OpenSourceSDRLab/B210-Kintex-7/hardware/mechanical/B210-Kintex-7_3D.step

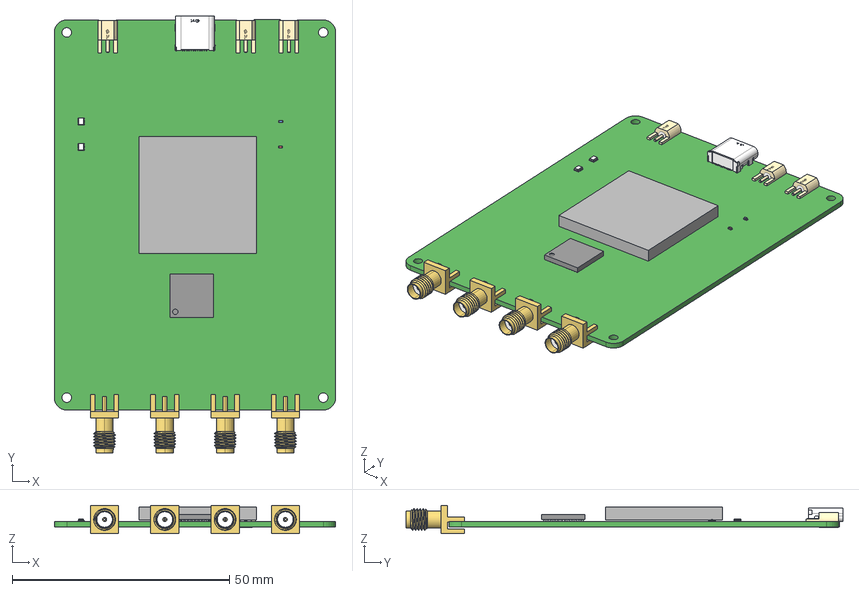
[picture p3: CAD file, 2026-09-02]
hardware/mechanical/B210-Kintex-7_3D.step
64.7 x 100.5 x 6.51 mm
LED-SMD_4P-L1.6-W1.5_F.1615.00003-P4-1615R1G1TA2-06T-001~LED-SMD_ 4P-L1.6-W1.5_F.1615.00003-P4-1615R1G1TA2-06T-001~NGzz x 2
LED-SMD_4P-L1.6-W1.5_F.1615.00003-P4-1615R1G1TA2-06T-001~LED-SMD_ 4P-L1.6-W1.5_F.1615.00003-P4-1615R1G1TA2-06T-001~NGzz001 x 2
LED-SMD_4P-L1.6-W1.5_F.1615.00003-P4-1615R1G1TA2-06T-001~LED-SMD_ 4P-L1.6-W1.5_F.1615.00003-P4-1615R1G1TA2-06T-001~NGzz002 x 2
LED-SMD_4P-L1.6-W1.5_F.1615.00003-P4-1615R1G1TA2-06T-001~LED-SMD_ 4P-L1.6-W1.5_F.1615.00003-P4-1615R1G1TA2-06T-001~NGzz003 x 2
LED-SMD_4P-L1.6-W1.5_F.1615.00003-P4-1615R1G1TA2-06T-001~LED-SMD_ 4P-L1.6-W1.5_F.1615.00003-P4-1615R1G1TA2-06T-001~NGzz004 x 2
LED-SMD_4P-L1.6-W1.5_F.1615.00003-P4-1615R1G1TA2-06T-001~LED-SMD_ 4P-L1.6-W1.5_F.1615.00003-P4-1615R1G1TA2-06T-001~NGzz005 x 2
LED-SMD_4P-L1.6-W1.5_F.1615.00003-P4-1615R1G1TA2-06T-001~LED-SMD_ 4P-L1.6-W1.5_F.1615.00003-P4-1615R1G1TA2-06T-001~NGzz006 x 2
LED-SMD_4P-L1.6-W1.5_F.1615.00003-P4-1615R1G1TA2-06T-001~LED-SMD_ 4P-L1.6-W1.5_F.1615.00003-P4-1615R1G1TA2-06T-001~NGzz007 x 2
LED-SMD_4P-L1.6-W1.5_F.1615.00003-P4-1615R1G1TA2-06T-001~LED-SMD_ 4P-L1.6-W1.5_F.1615.00003-P4-1615R1G1TA2-06T-001~NGzz008 x 2
LED-SMD_4P-L1.6-W1.5_F.1615.00003-P4-1615R1G1TA2-06T-001~LED-SMD_ 4P-L1.6-W1.5_F.1615.00003-P4-1615R1G1TA2-06T-001~NGzz009 x 2
Extruded
SMA-SMD_73415-0963~SMA-SMD_73415-0963~VM4T x 3
USB-C-SMD_TYPE-C-24P-QT~USB-C-SMD_TYPE-C-24P-QT~8yyD
USB-C-SMD_TYPE-C-24P-QT~USB-C-SMD_TYPE-C-24P-QT~8yyD001
USB-C-SMD_TYPE-C-24P-QT~USB-C-SMD_TYPE-C-24P-QT~8yyD002
USB-C-SMD_TYPE-C-24P-QT~USB-C-SMD_TYPE-C-24P-QT~8yyD003
USB-C-SMD_TYPE-C-24P-QT~USB-C-SMD_TYPE-C-24P-QT~8yyD004
USB-C-SMD_TYPE-C-24P-QT~USB-C-SMD_TYPE-C-24P-QT~8yyD005
USB-C-SMD_TYPE-C-24P-QT~USB-C-SMD_TYPE-C-24P-QT~8yyD006
USB-C-SMD_TYPE-C-24P-QT~USB-C-SMD_TYPE-C-24P-QT~8yyD007
USB-C-SMD_TYPE-C-24P-QT~USB-C-SMD_TYPE-C-24P-QT~8yyD008
USB-C-SMD_TYPE-C-24P-QT~USB-C-SMD_TYPE-C-24P-QT~8yyD009
USB-C-SMD_TYPE-C-24P-QT~USB-C-SMD_TYPE-C-24P-QT~8yyD010
USB-C-SMD_TYPE-C-24P-QT~USB-C-SMD_TYPE-C-24P-QT~8yyD011
USB-C-SMD_TYPE-C-24P-QT~USB-C-SMD_TYPE-C-24P-QT~8yyD012
USB-C-SMD_TYPE-C-24P-QT~USB-C-SMD_TYPE-C-24P-QT~8yyD013
USB-C-SMD_TYPE-C-24P-QT~USB-C-SMD_TYPE-C-24P-QT~8yyD014
User Library-led_0402
SMA-KE x 4
LOGOԲ0.25 x 4
User Library-led_0402LED0402 blue
