OpenSourceSDRLab/B210-Kintex-7/(list of files, cad)

Other CAD files:
hardware/mechanical/B210-Kintex-7_outline.dwg
