OpenSourceSDRLab/B210-Kintex-7/hardware/B210-Kintex-7_Schematic.pdf

# © 2026 OpenSourceSDRLab. All rights reserved. · www.opensourcesdrlab.com

# OPENSOURCESDRLAB DOCUMENTATION

# B210-Kintex-7 Schematic

Product | B210-Kintex-7
Document | OSSDRLAB-B210-Kintex-7-SCH
Version | 2.1
Date | 2026-11-12

Circuit schematic (board revision V2.1) of the OpenSourceSDRLab B210-Kintex-7, a USRP B210-compatible SDR with an Analog Devices AD9361 and a Xilinx Kintex-7 XC7K325T FPGA. Exported from Altium Designer (A4); sheet 13 is blank.

Sheet | Content
1–2 | USB 3.0: CYUSB3014 (FX3) controller, GPIF II bus, Type-C connector and FX3 supply
3 | Power: MP2143 step-down converters, TPS7A9201 low-noise LDOs
4–5 | FPGA configuration, core supply (TPS53355), power pins and decoupling
6–7 | FPGA HR/HP I/O banks: AD9361 interface, FX3 GPIF II, PLL, GPS, GPIO
8 | AD9361 RF transceiver
9–10 | RF front ends, channel 1 (TRX1, RX1) and channel 2 (TRX2, RX2)
11 | Status LEDs, GPIO/JTAG FPC connector
12 | Clocking: ADF4001 PLL, 10 MHz and PPS inputs, onboard GPS module

# Product page: https://opensourcesdrlab.com/products/b210-kintex-7

# Questions about the hardware: support@opensourcesdrlab.com

11

22

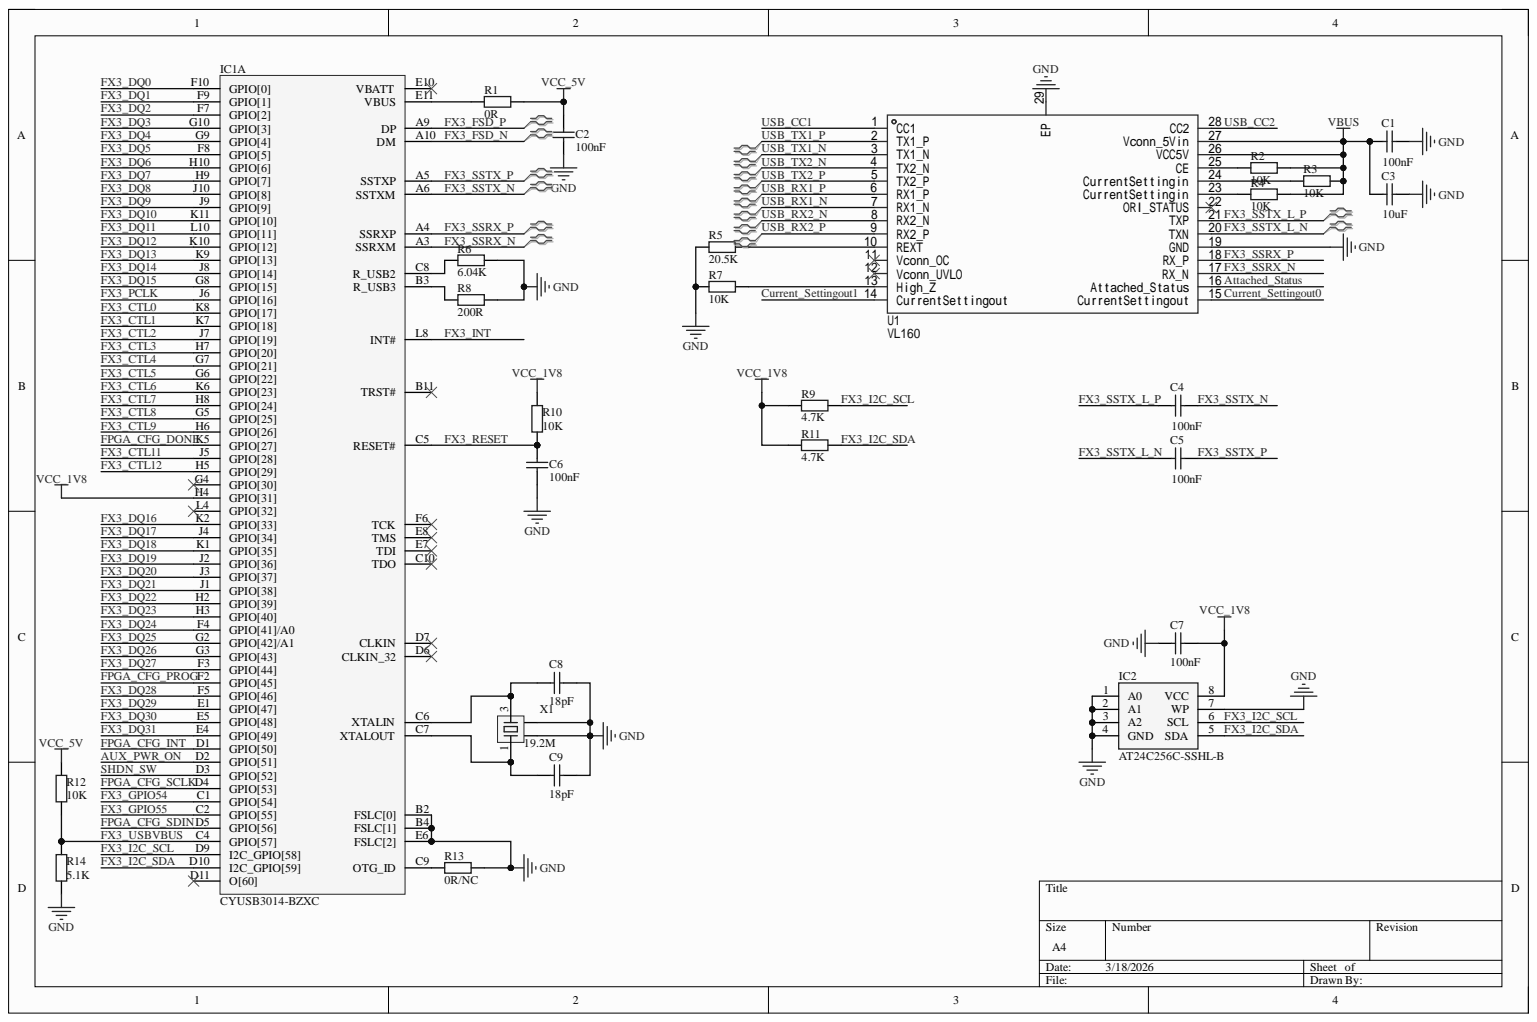
[picture p8: page 2]

A | A
NC | A11

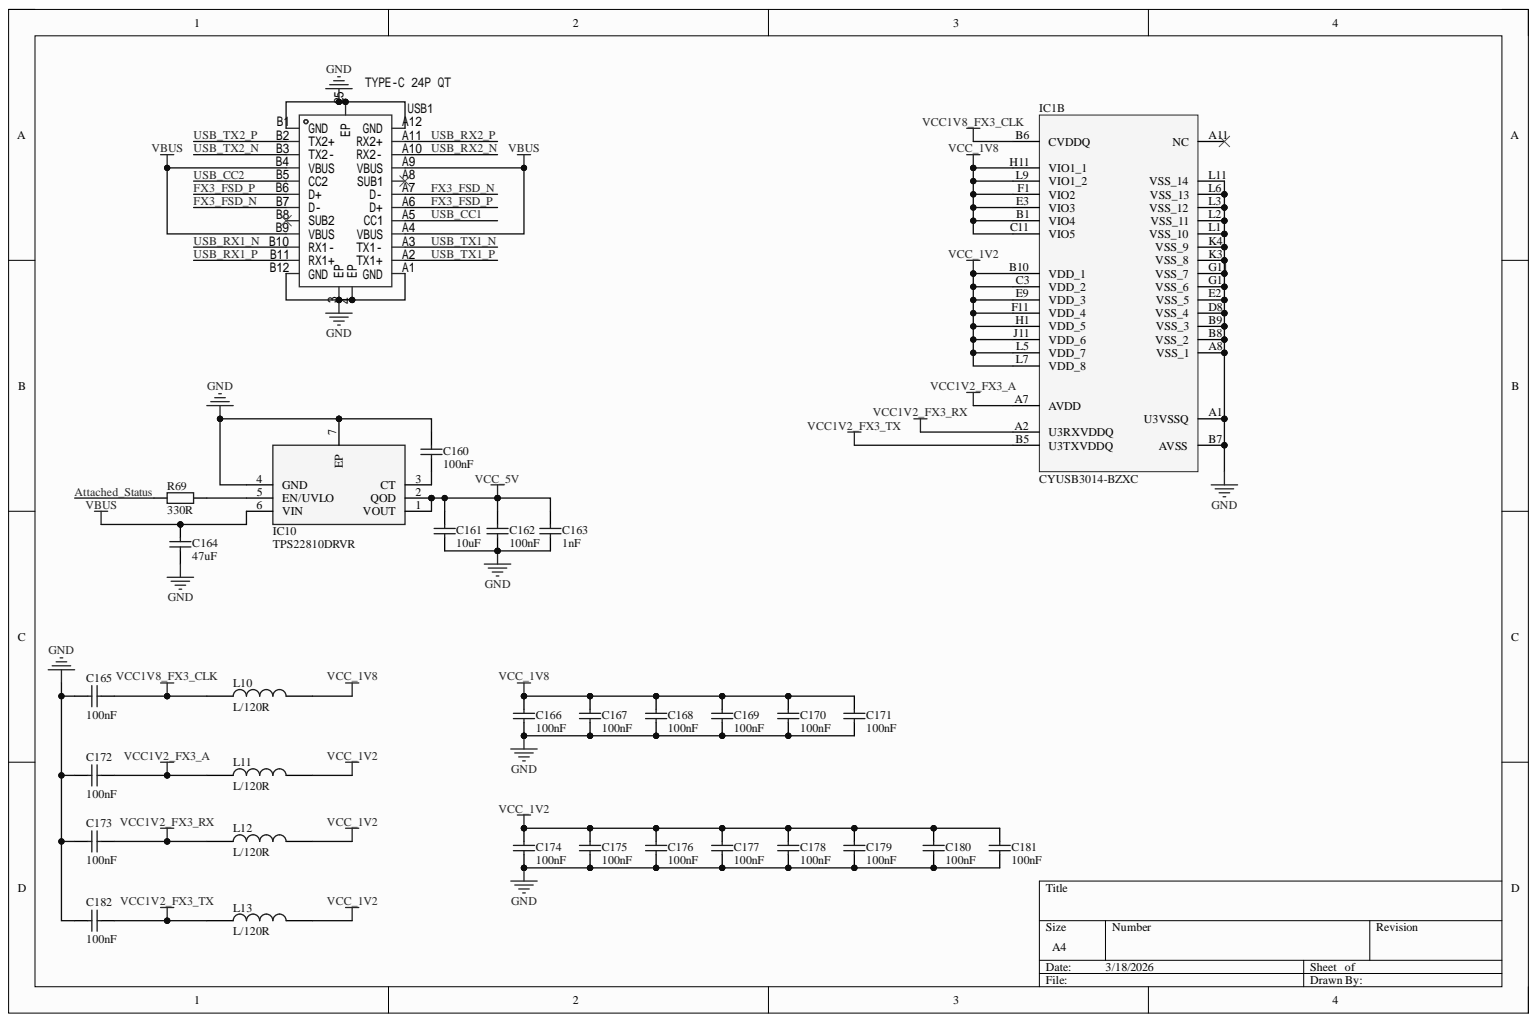
[picture p9: page 3]

A | A
PG | 1

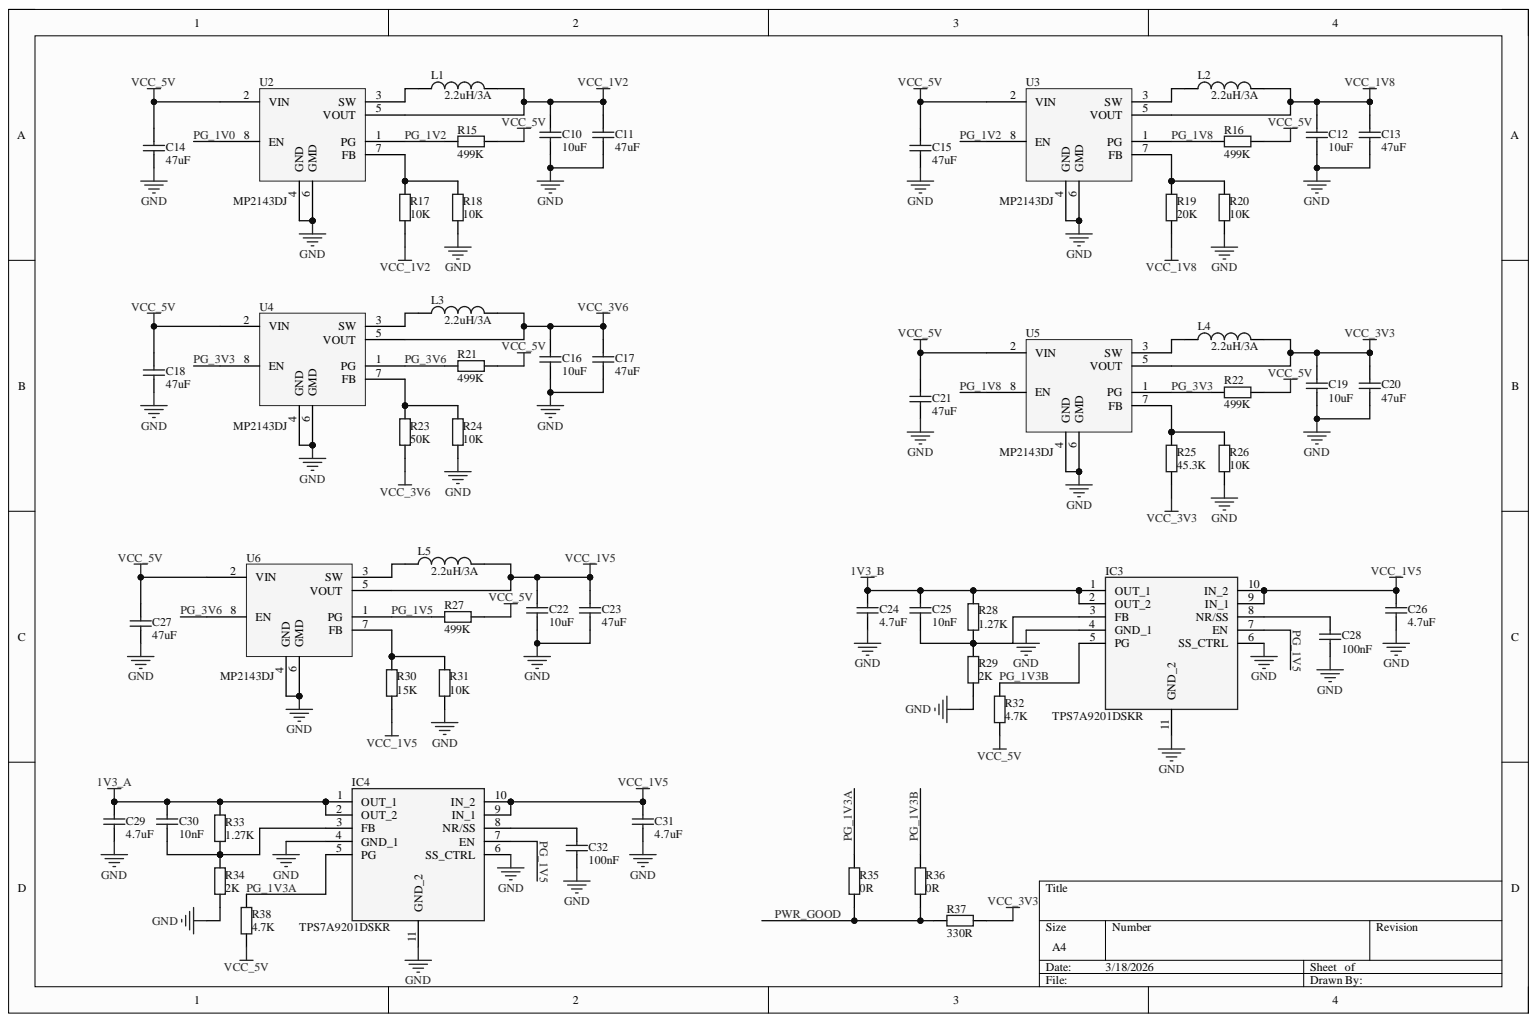
[picture p10: page 4]

A | A
INIT_B_0 G7 | DONE_0 J7

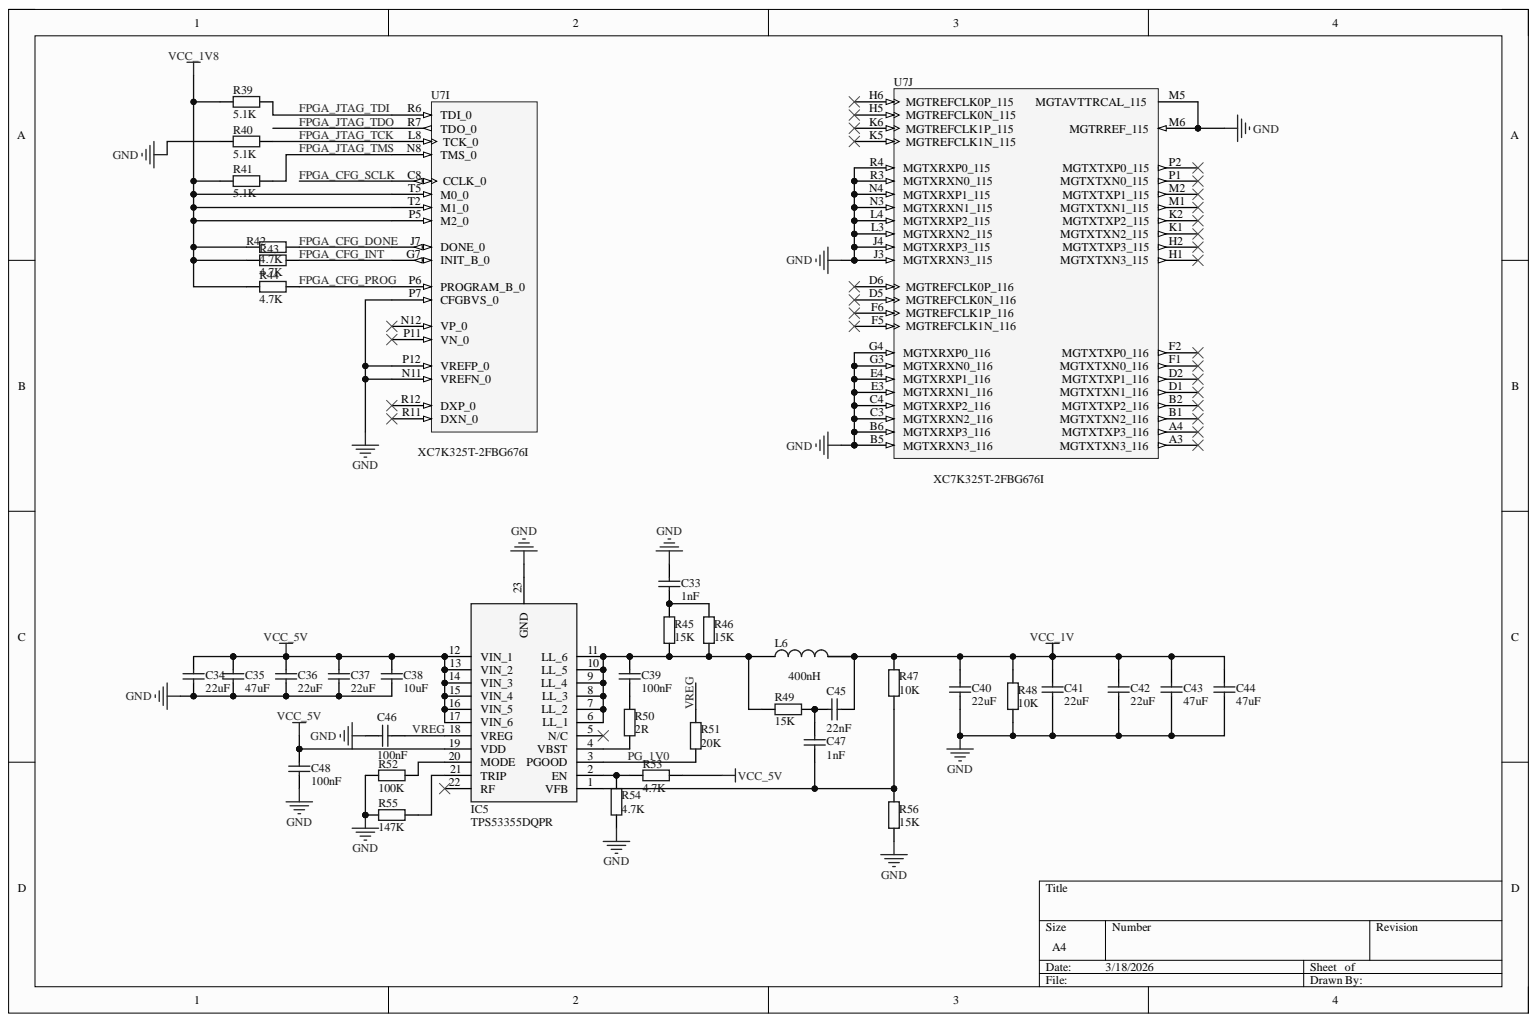
[picture p11: page 5]

VCCINT U15 | VCCINT T14 | VCCINT R15 | VCCINT P14 | VCCINT N15 | VCCINT N9 | VCCINT M14 | VCCINT M8 | VCCINT L15 | VCCINT L13 | VCCINT L9 | VCCINT K14 | VCCINT K12 | VCCINT K10 | VCCINT K8 | VCCINT J9
GND | Y19 GND | Y9 GND | W22 GND | W12 GND | W2 GND | V25 GND | V15 GND | V5 GND | U18 GND | U14 GND | U12 GND | U10 GND | U8 GND | T21 GND | T15 GND | T13 GND | T11 GND | T9 GND | T4 GND | T3 GND | T1 GND | R24 GND | R14 GND | R10 GND | R8 GND | R5 GND | R2 GND | R1 GND | P17 GND | P15 GND | P13 GND | P9 GND | P4 GND | P3 GND | N20 GND | N14 GND | N10 GND | N7 GND | N5 GND | N2 GND | N1 GND | M23 GND | M15 GND | M13

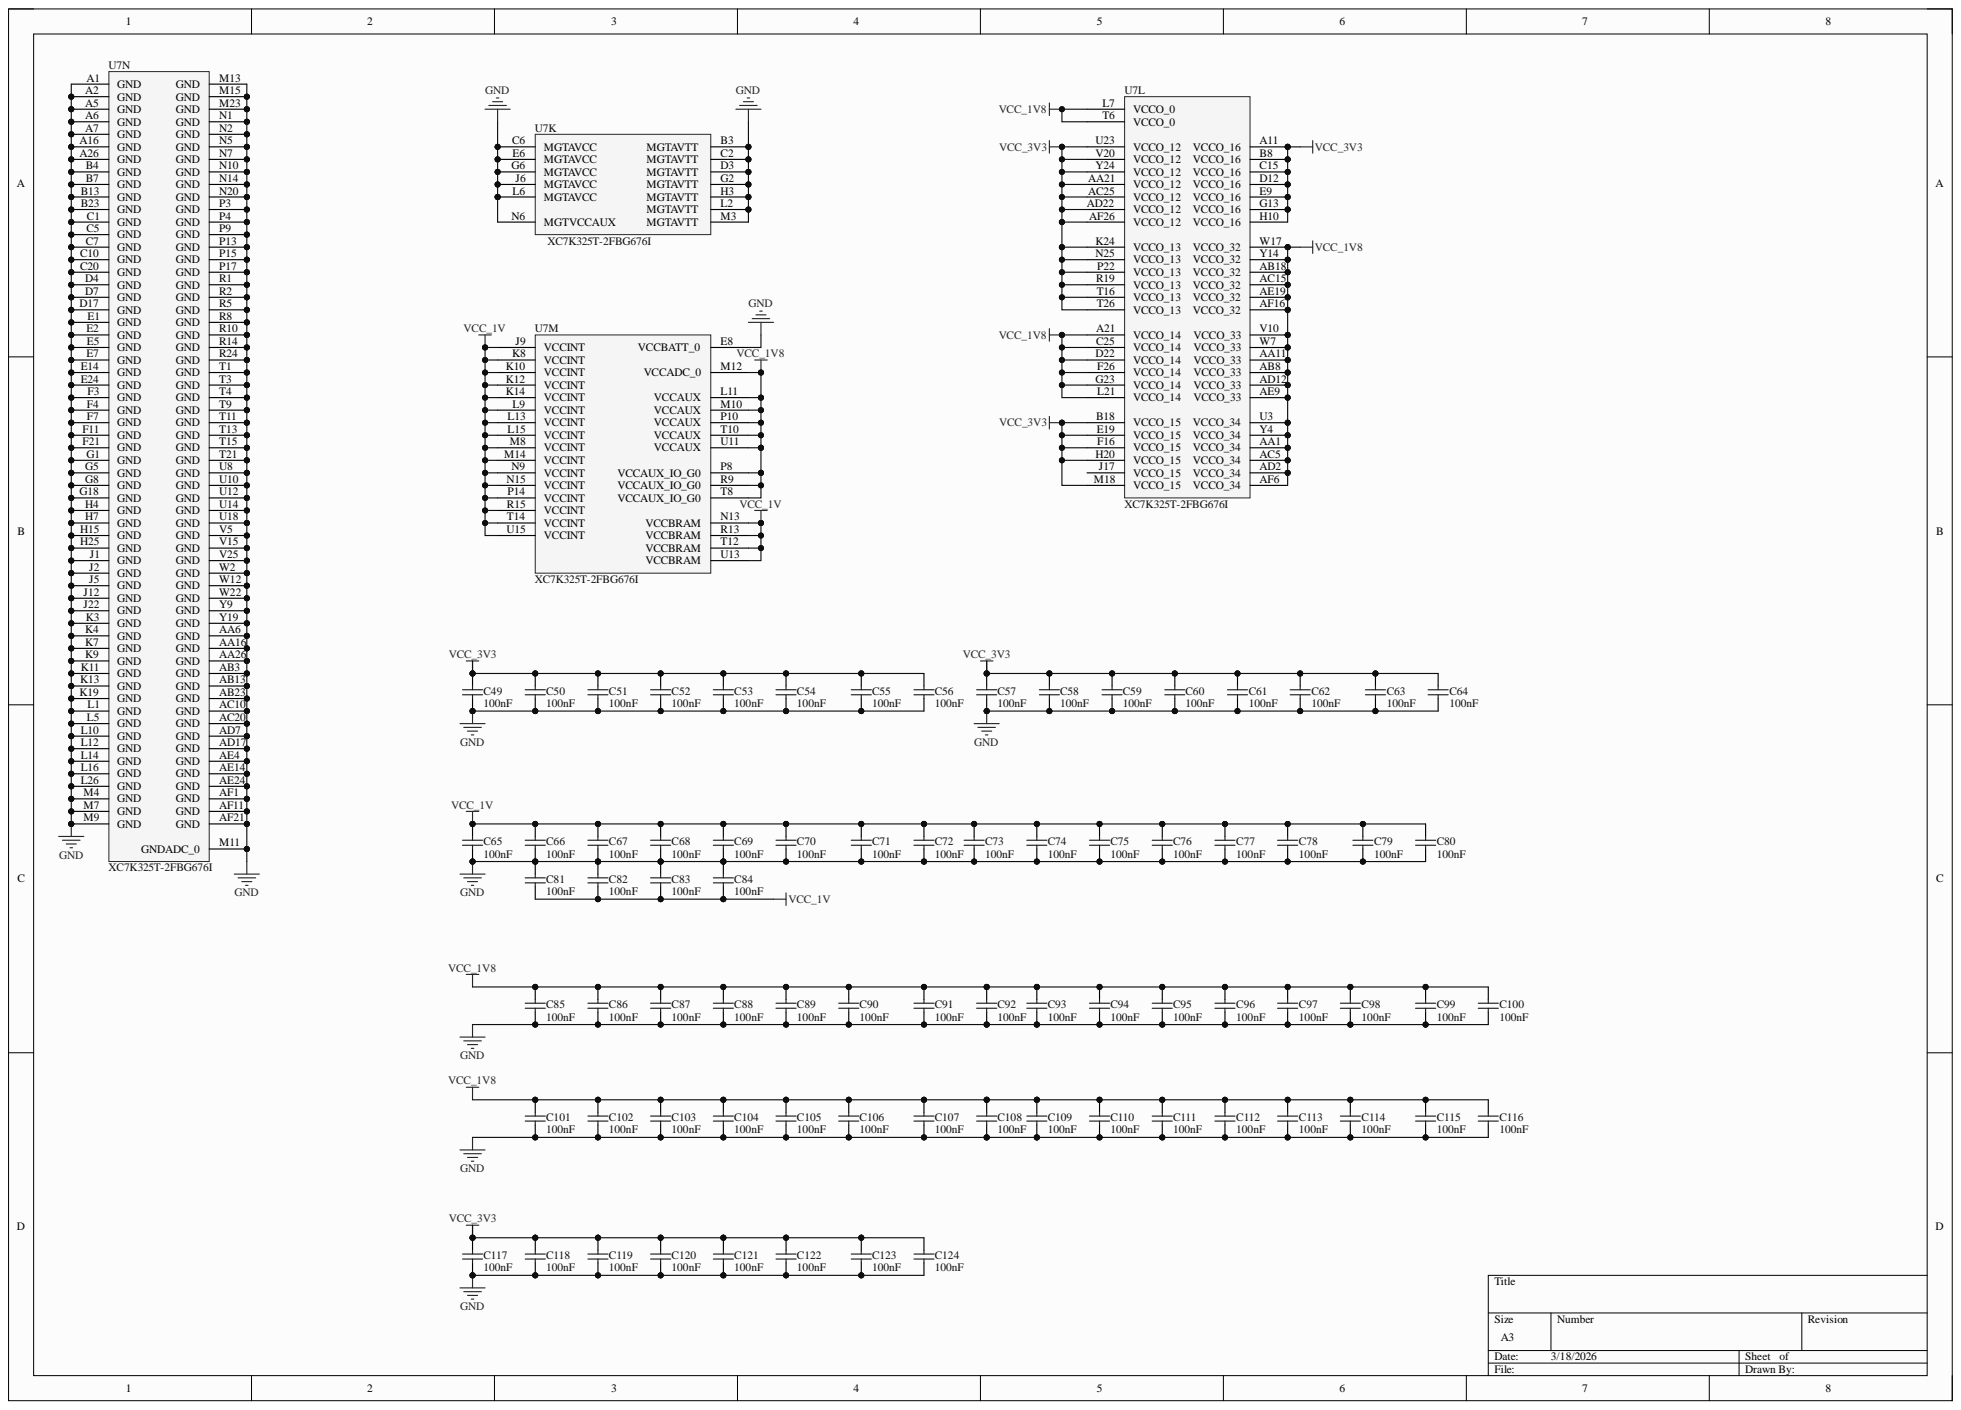
[picture p12: page 6]

# U7A XC7K325T

# U7B XC7K325T

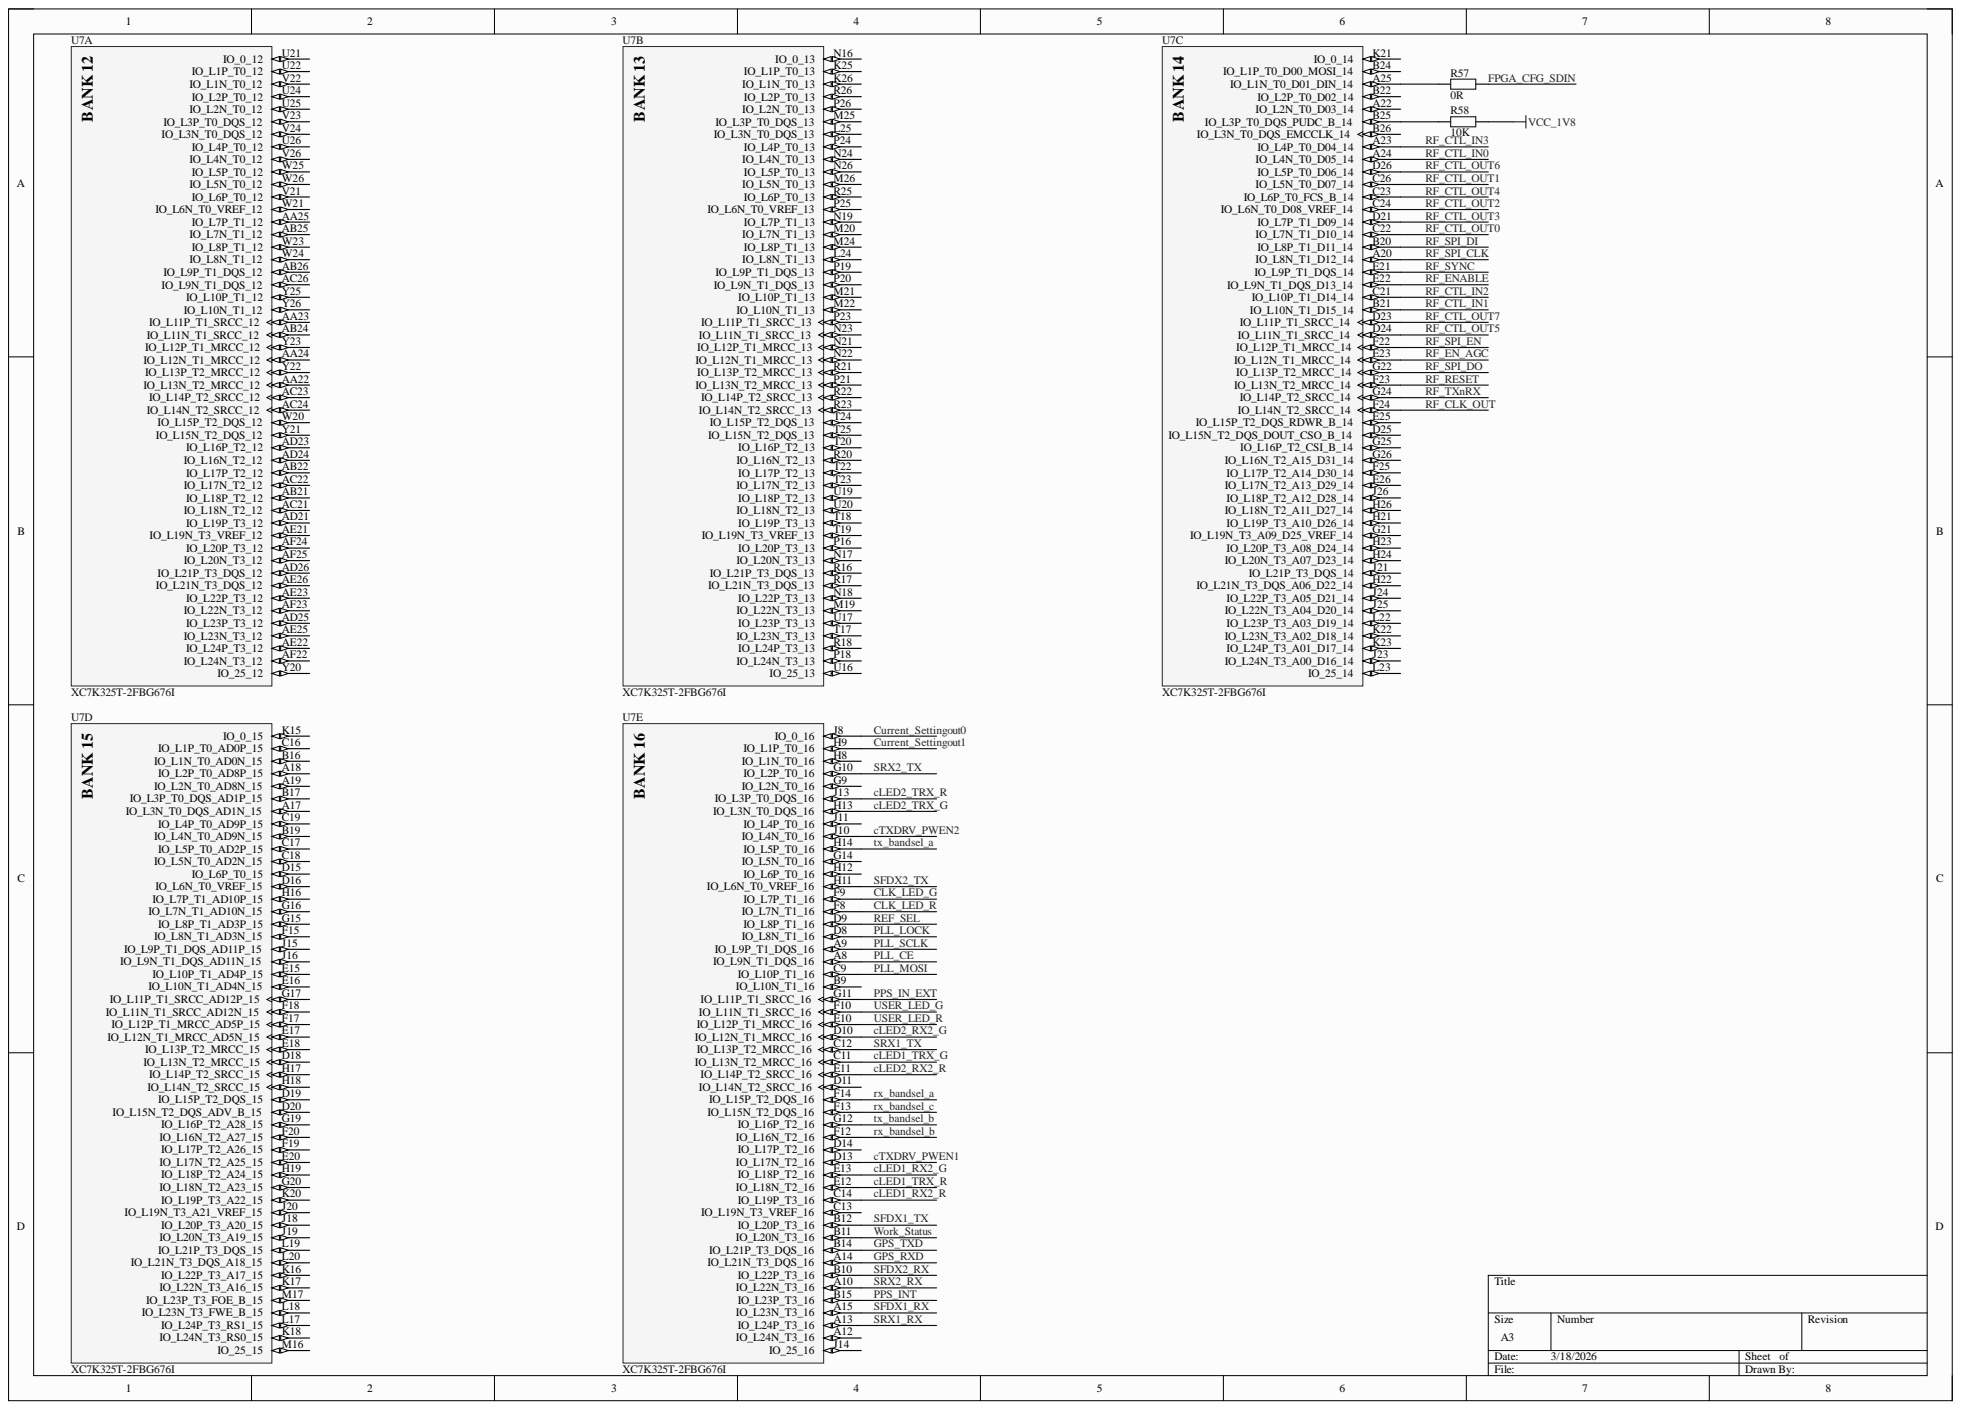
[picture p13: page 7]

11

22

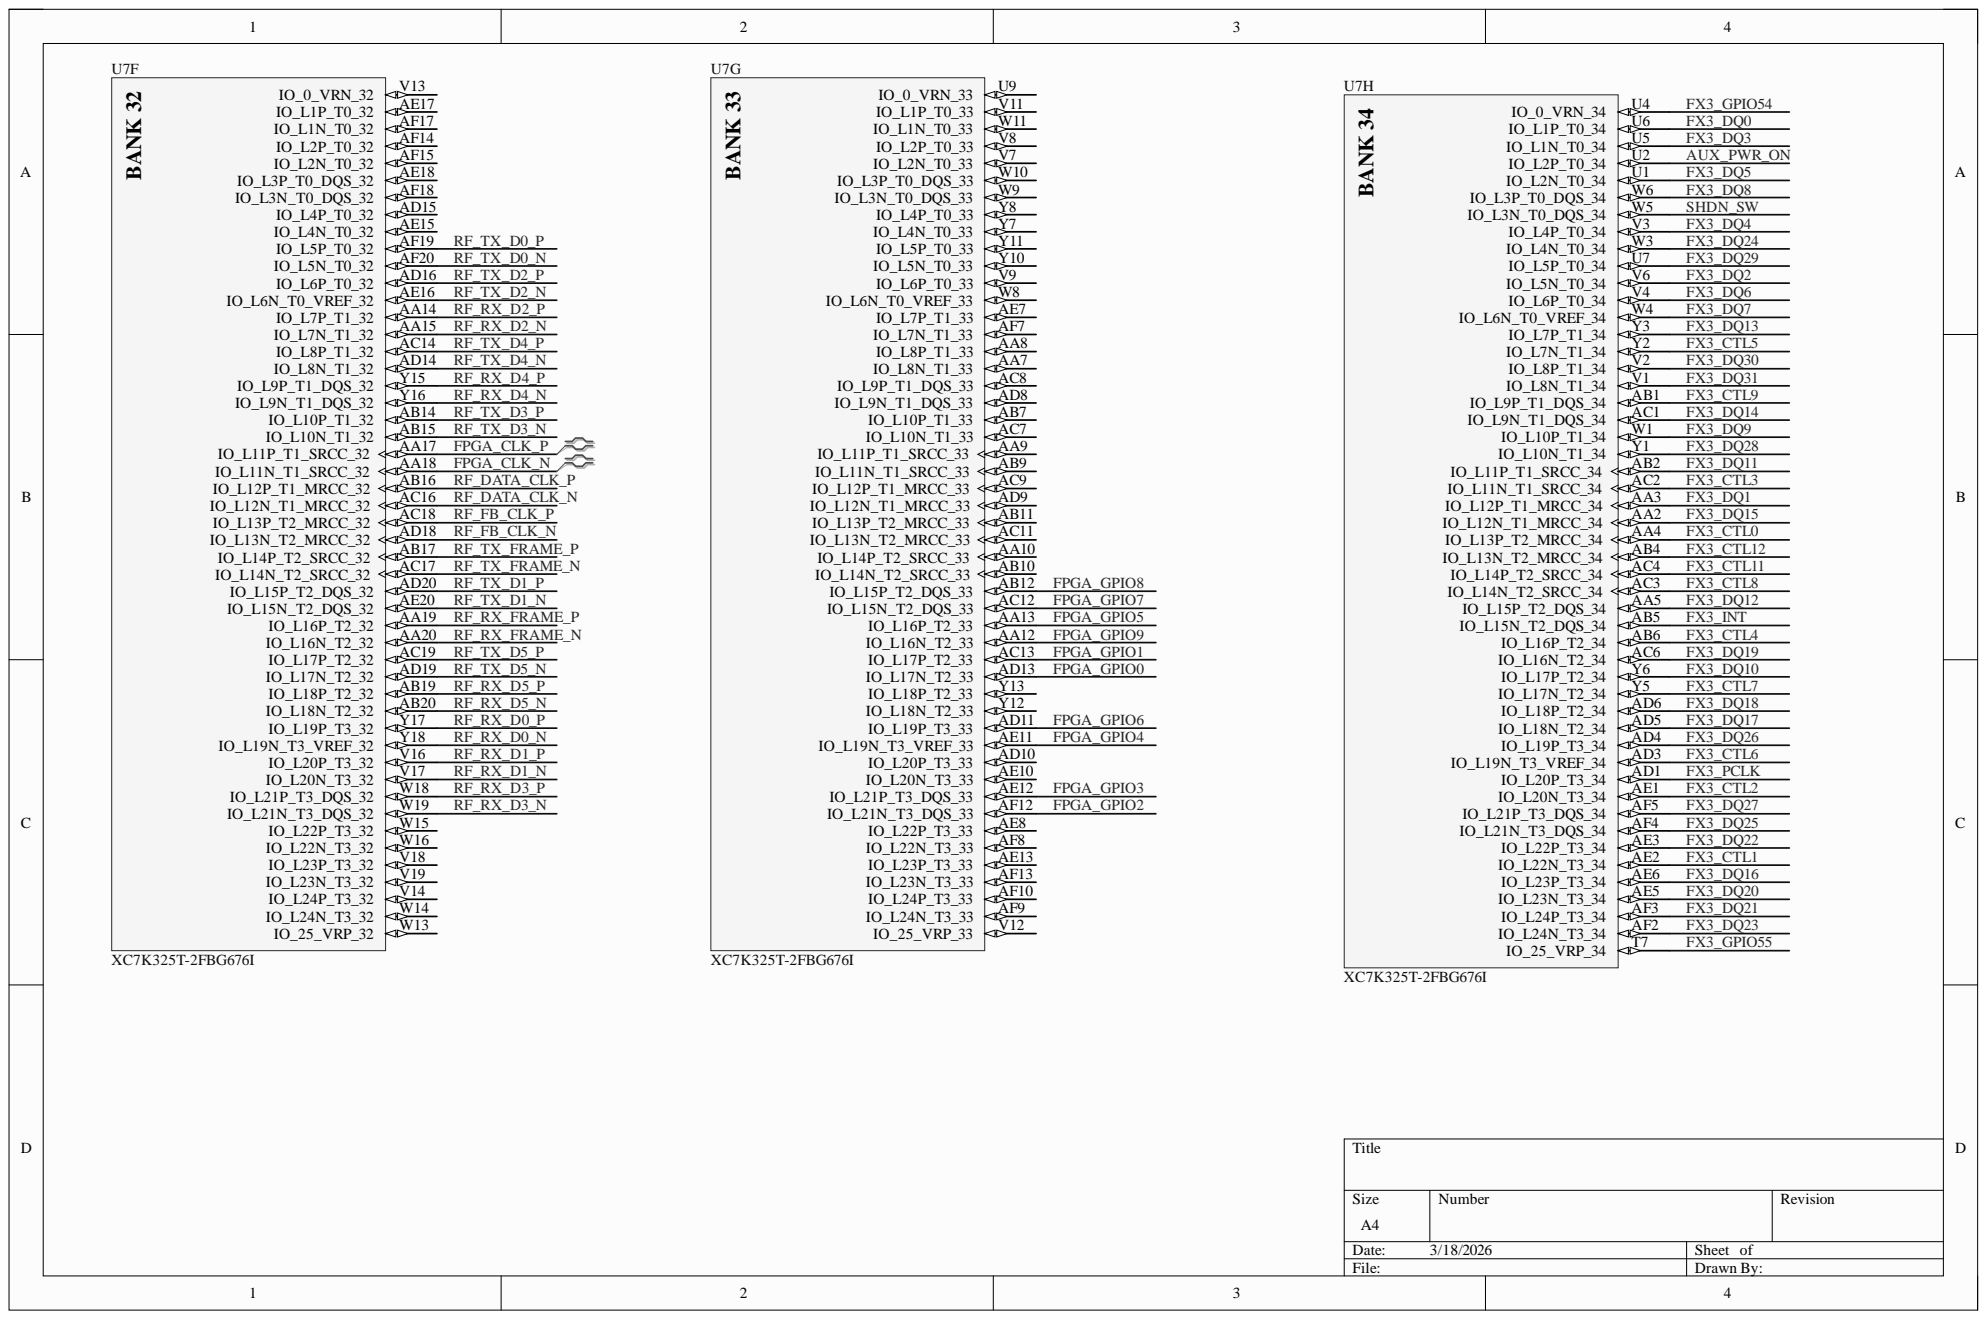
[picture p14: page 8]

11

22

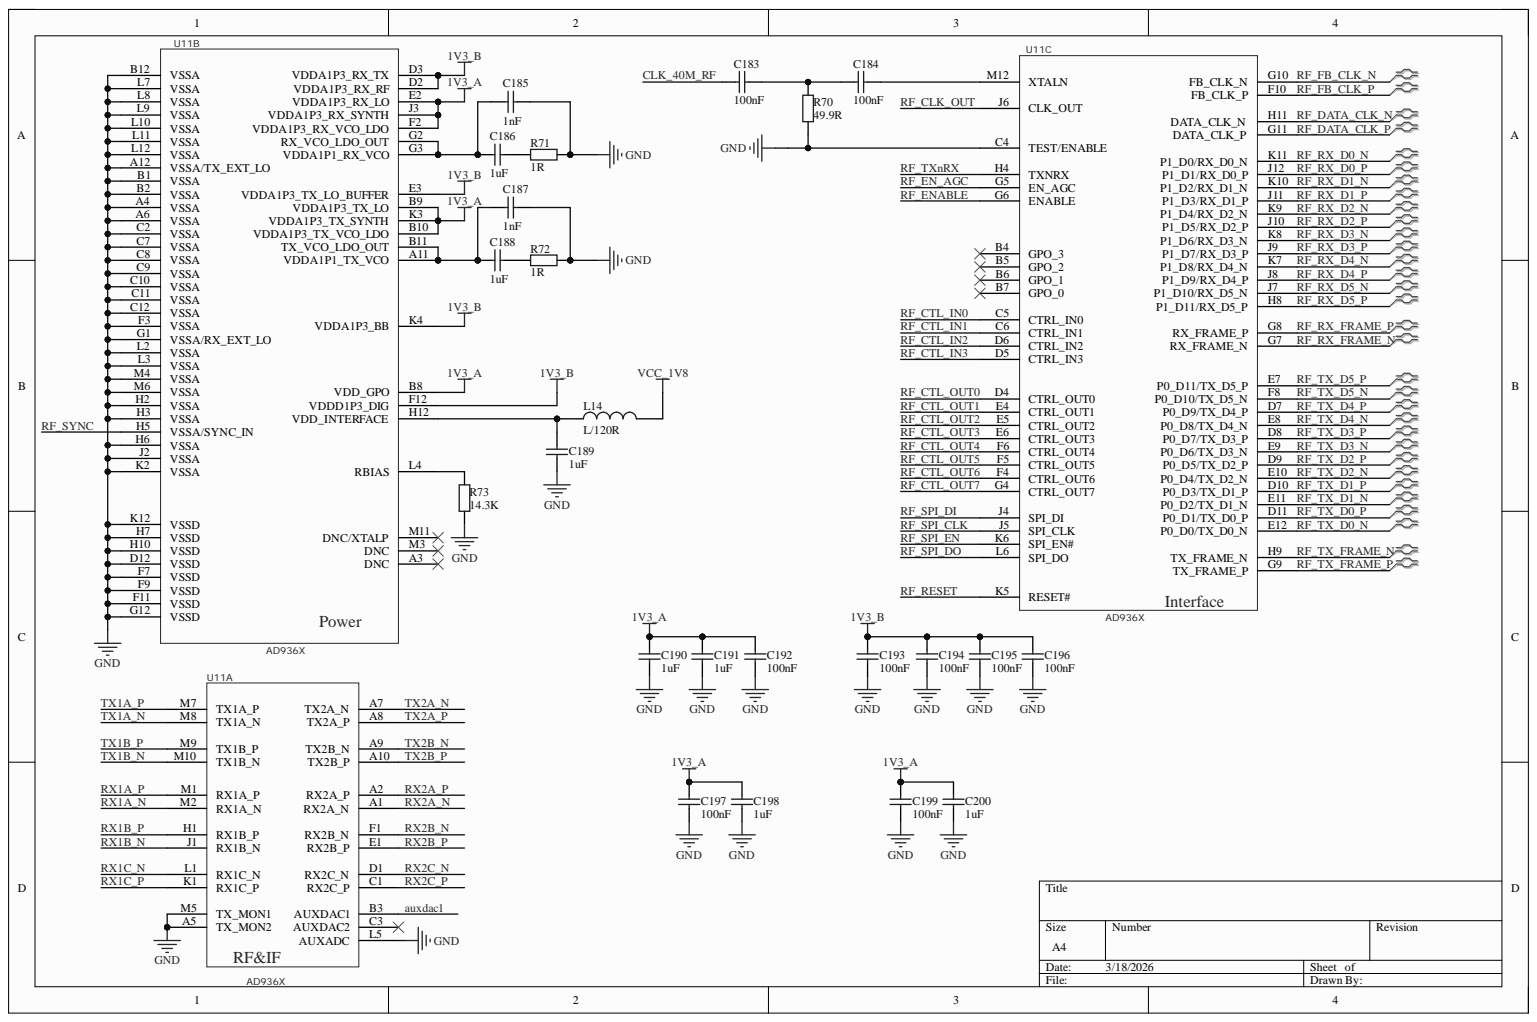
[picture p15: page 9]

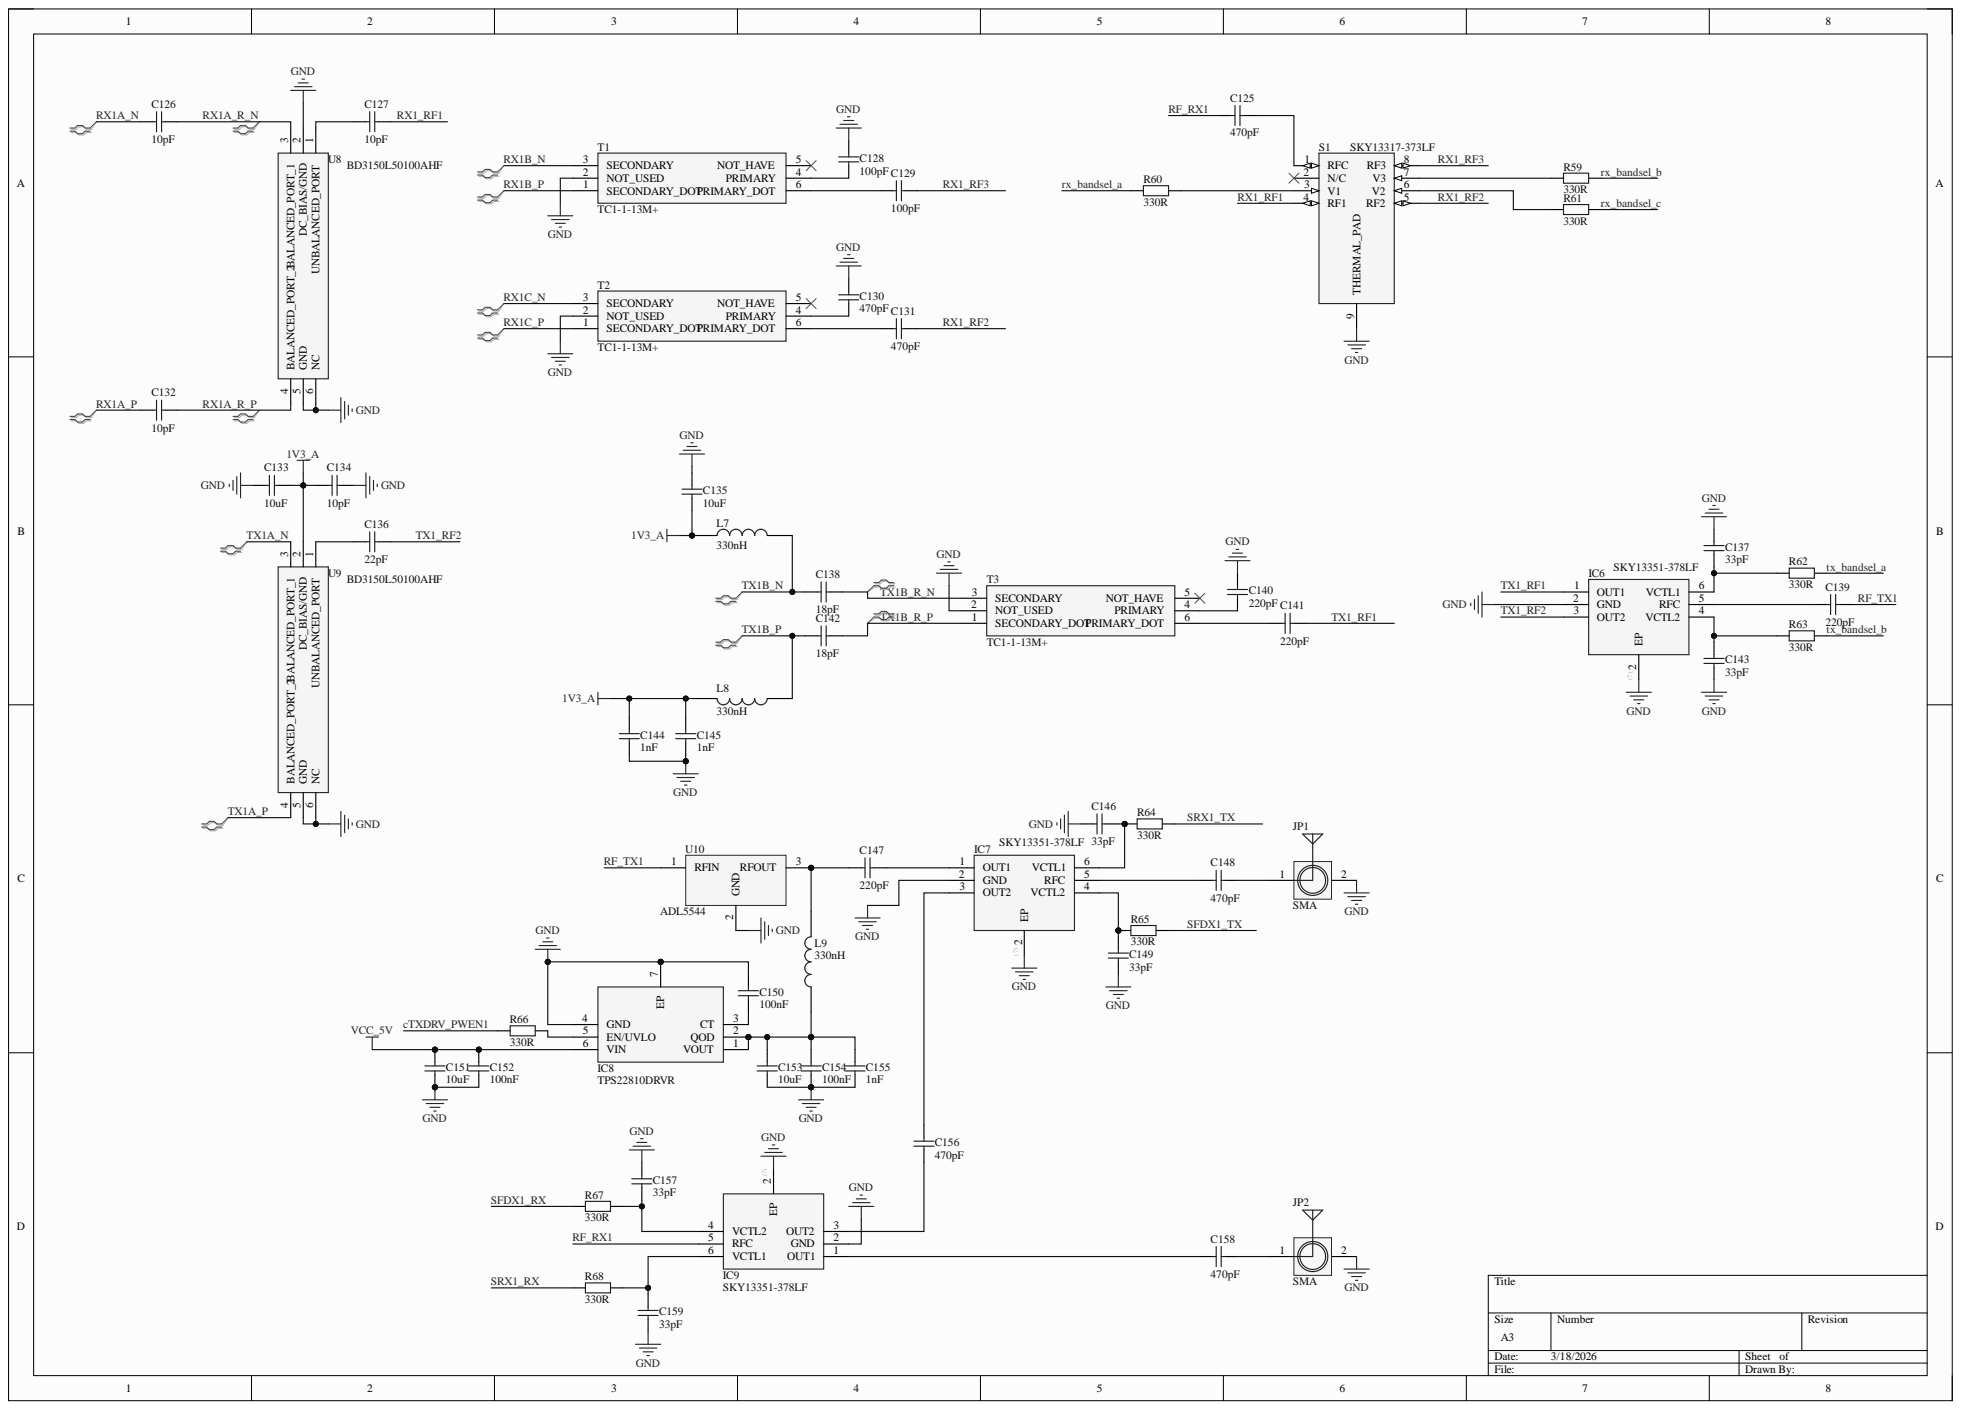
[picture p16: page 10]

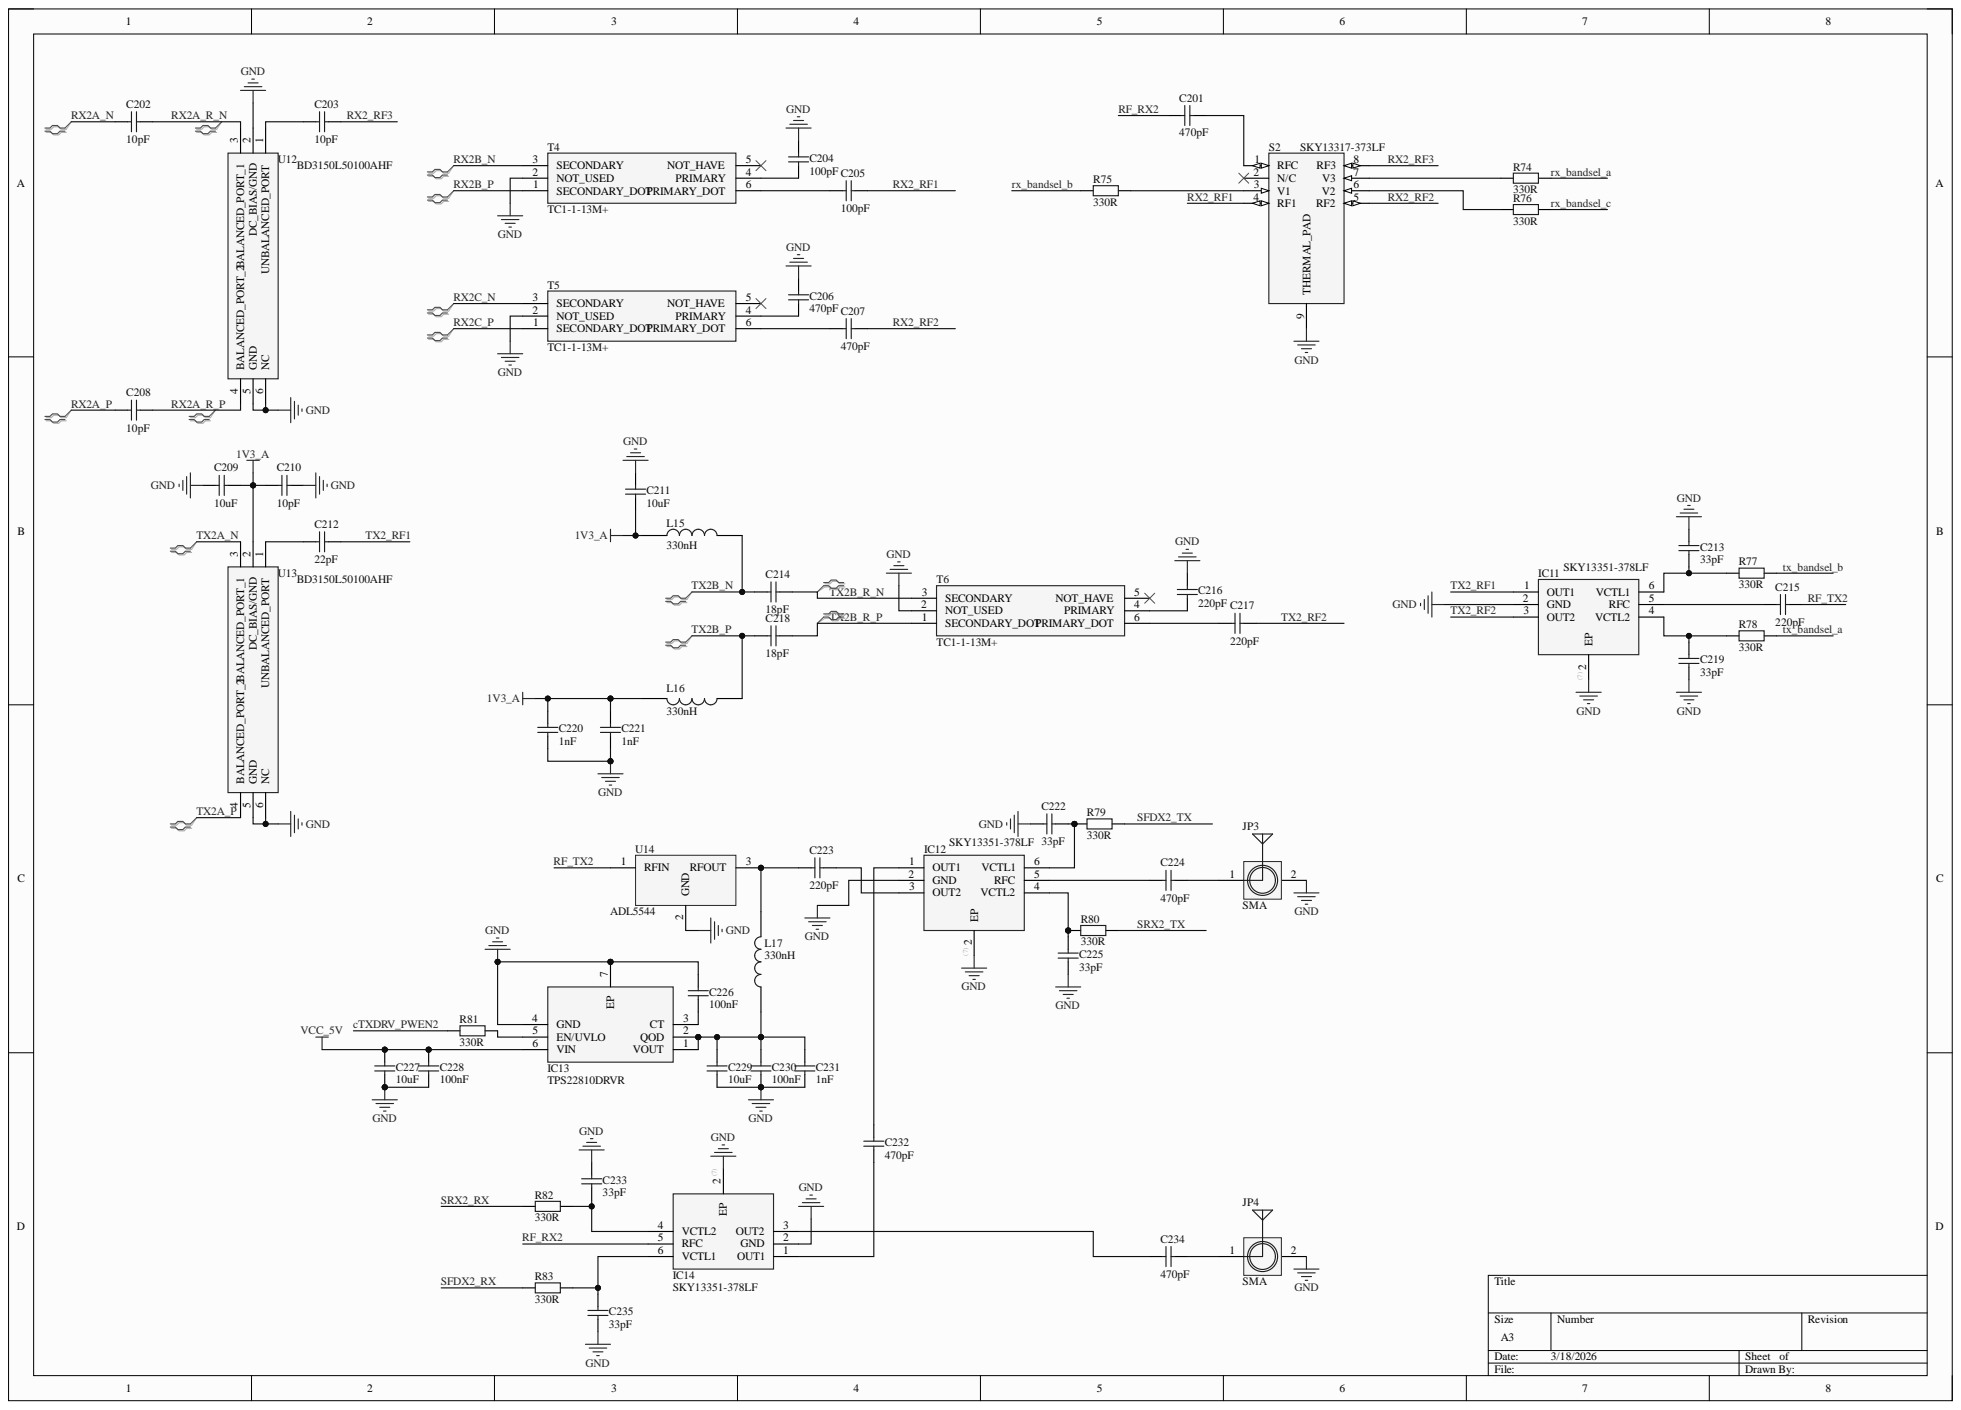
[picture p17: page 11]

11

22

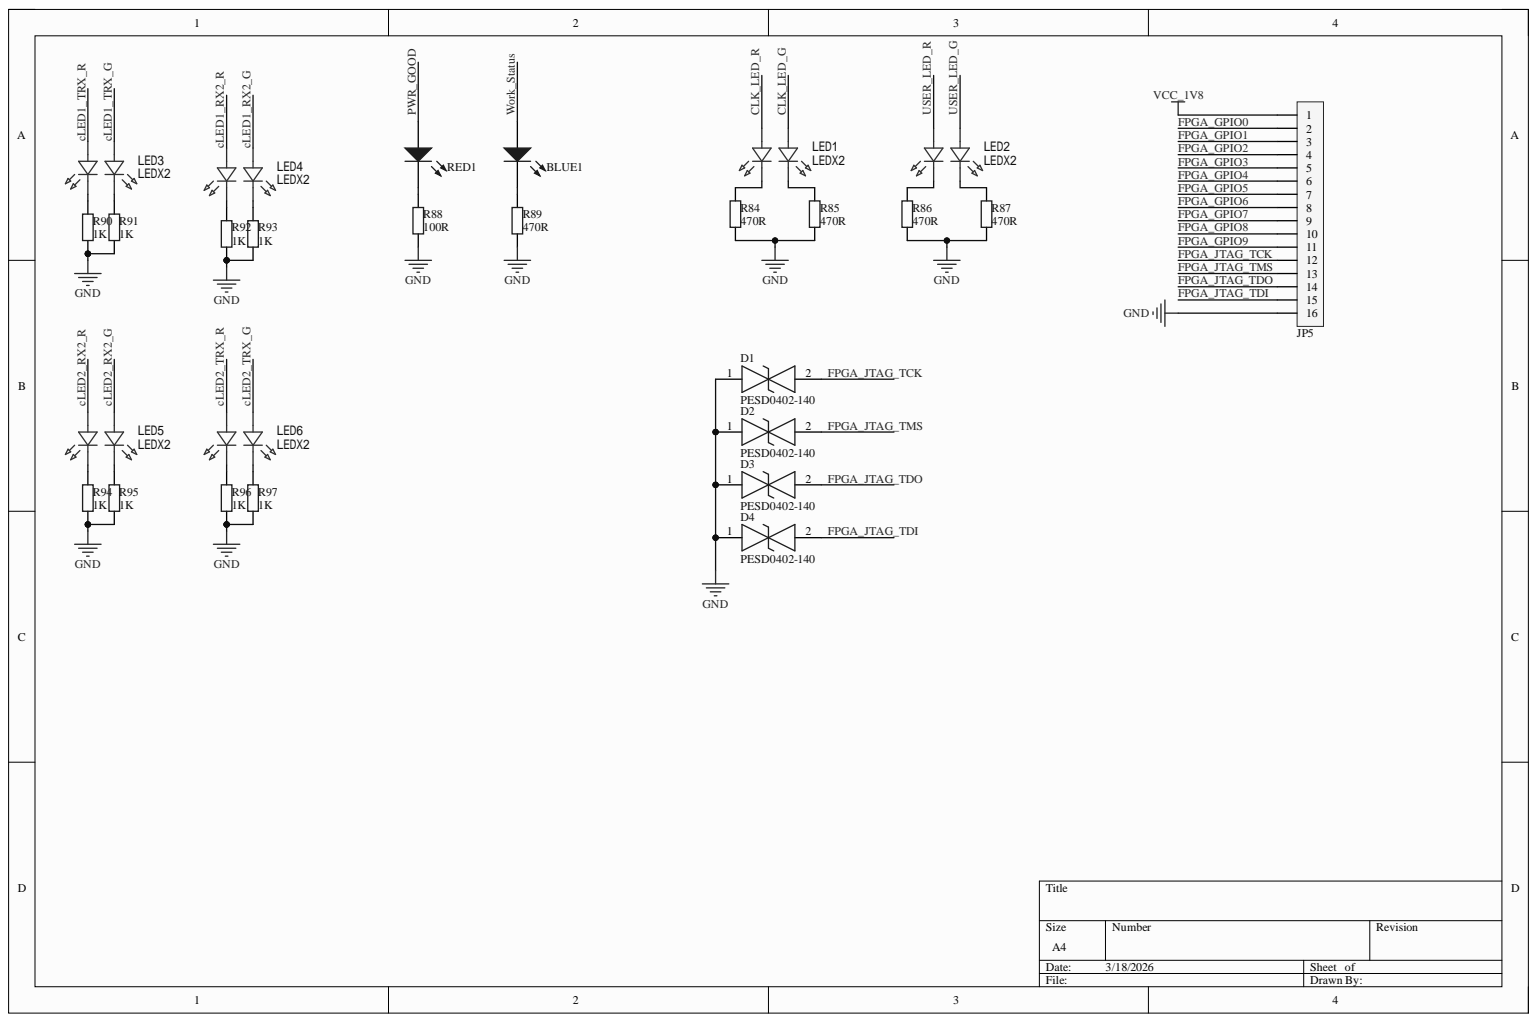
[picture p18: page 12]

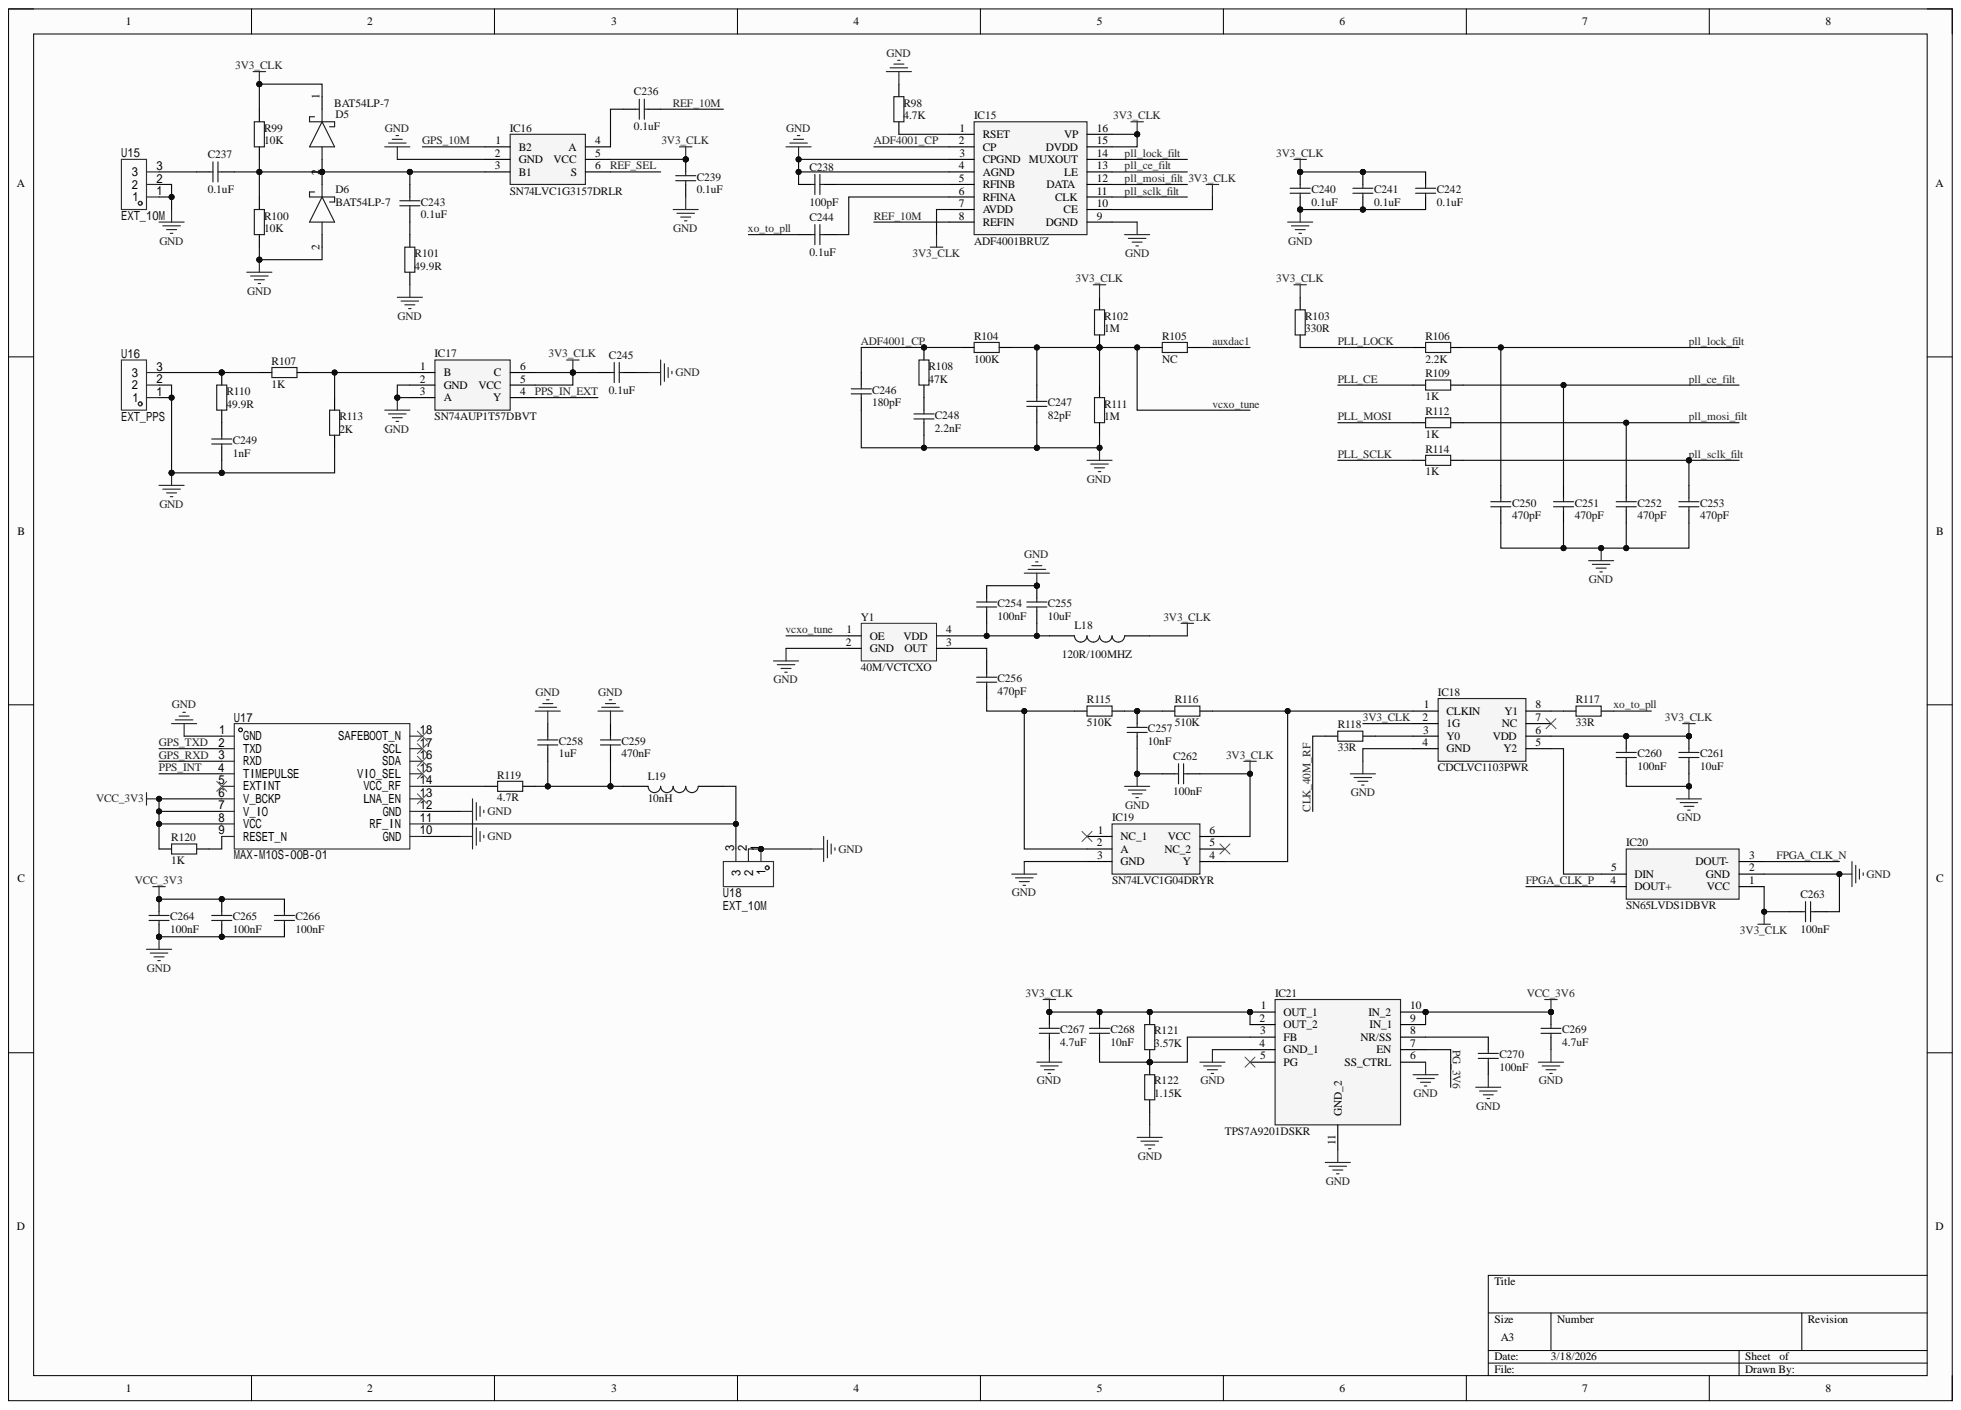
[picture p19: page 13]
