OpenSourceSDRLab/B210-Kintex-7/hardware/K7_B210_V2.1.pdf

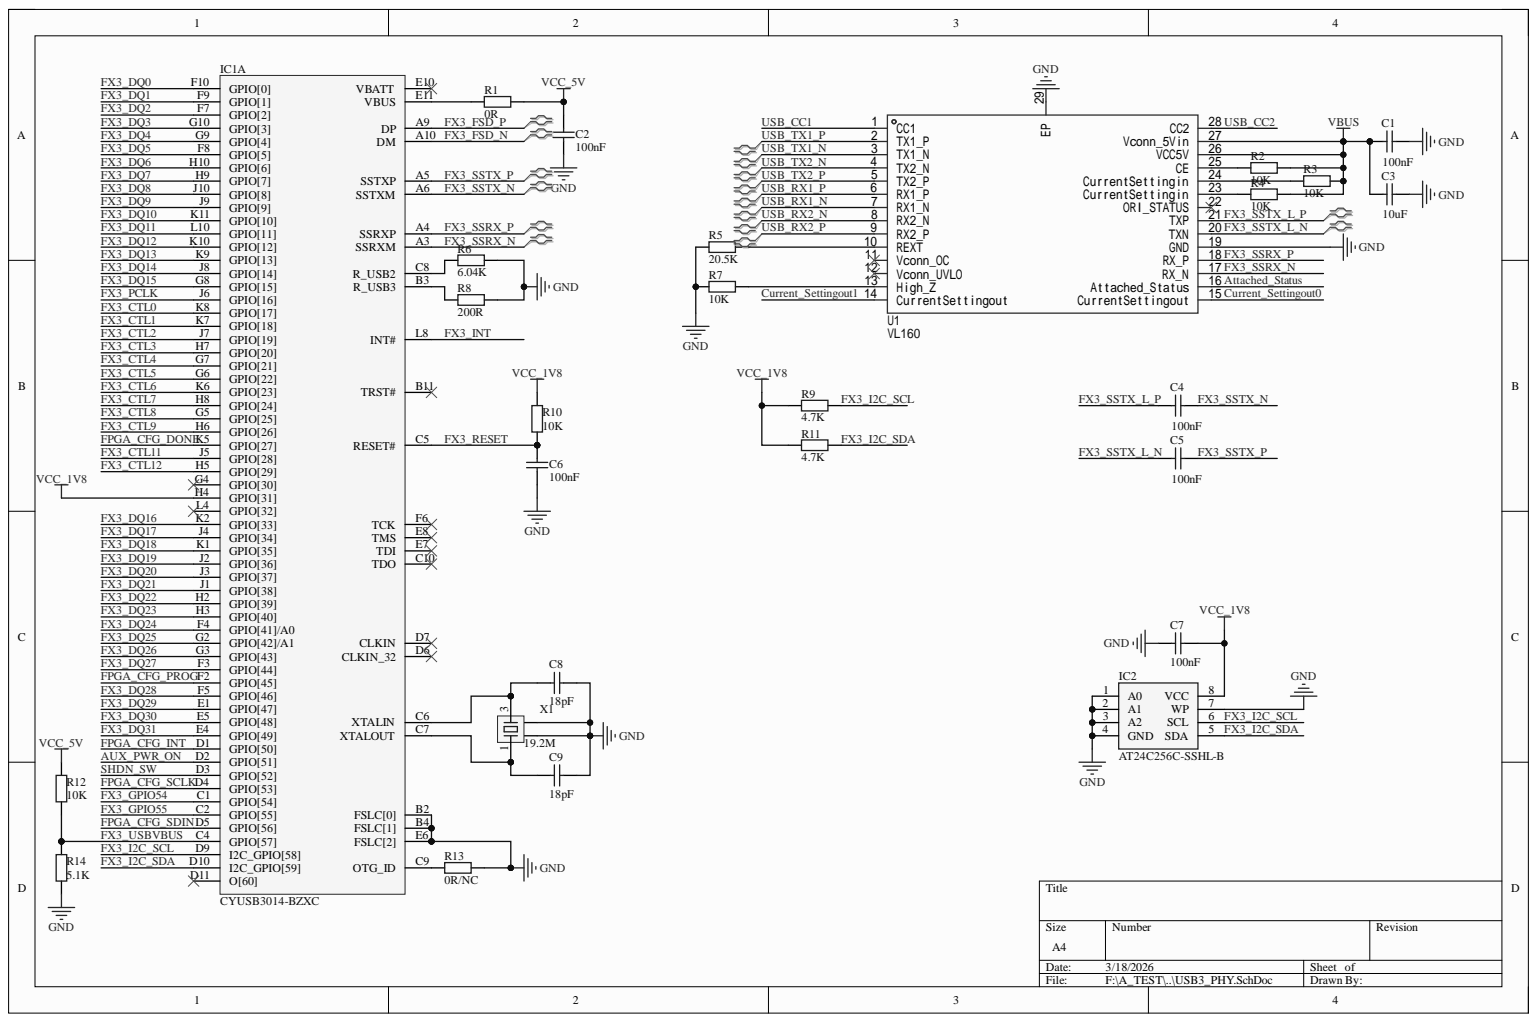
[picture p20: page 1]

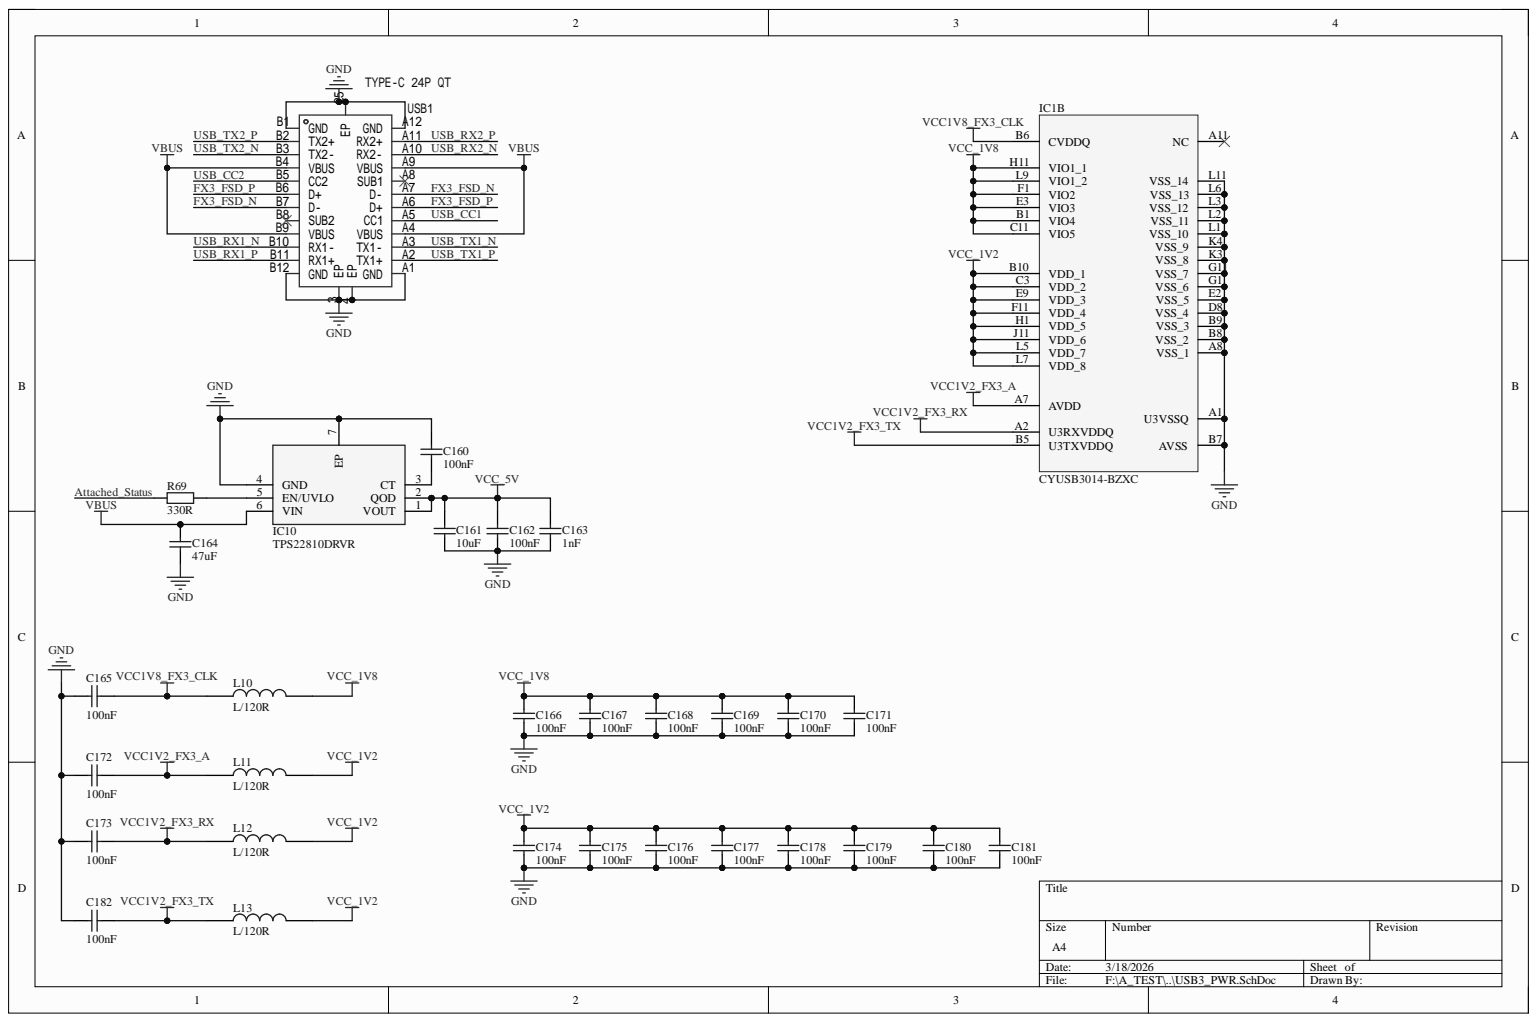
[picture p21: page 2]

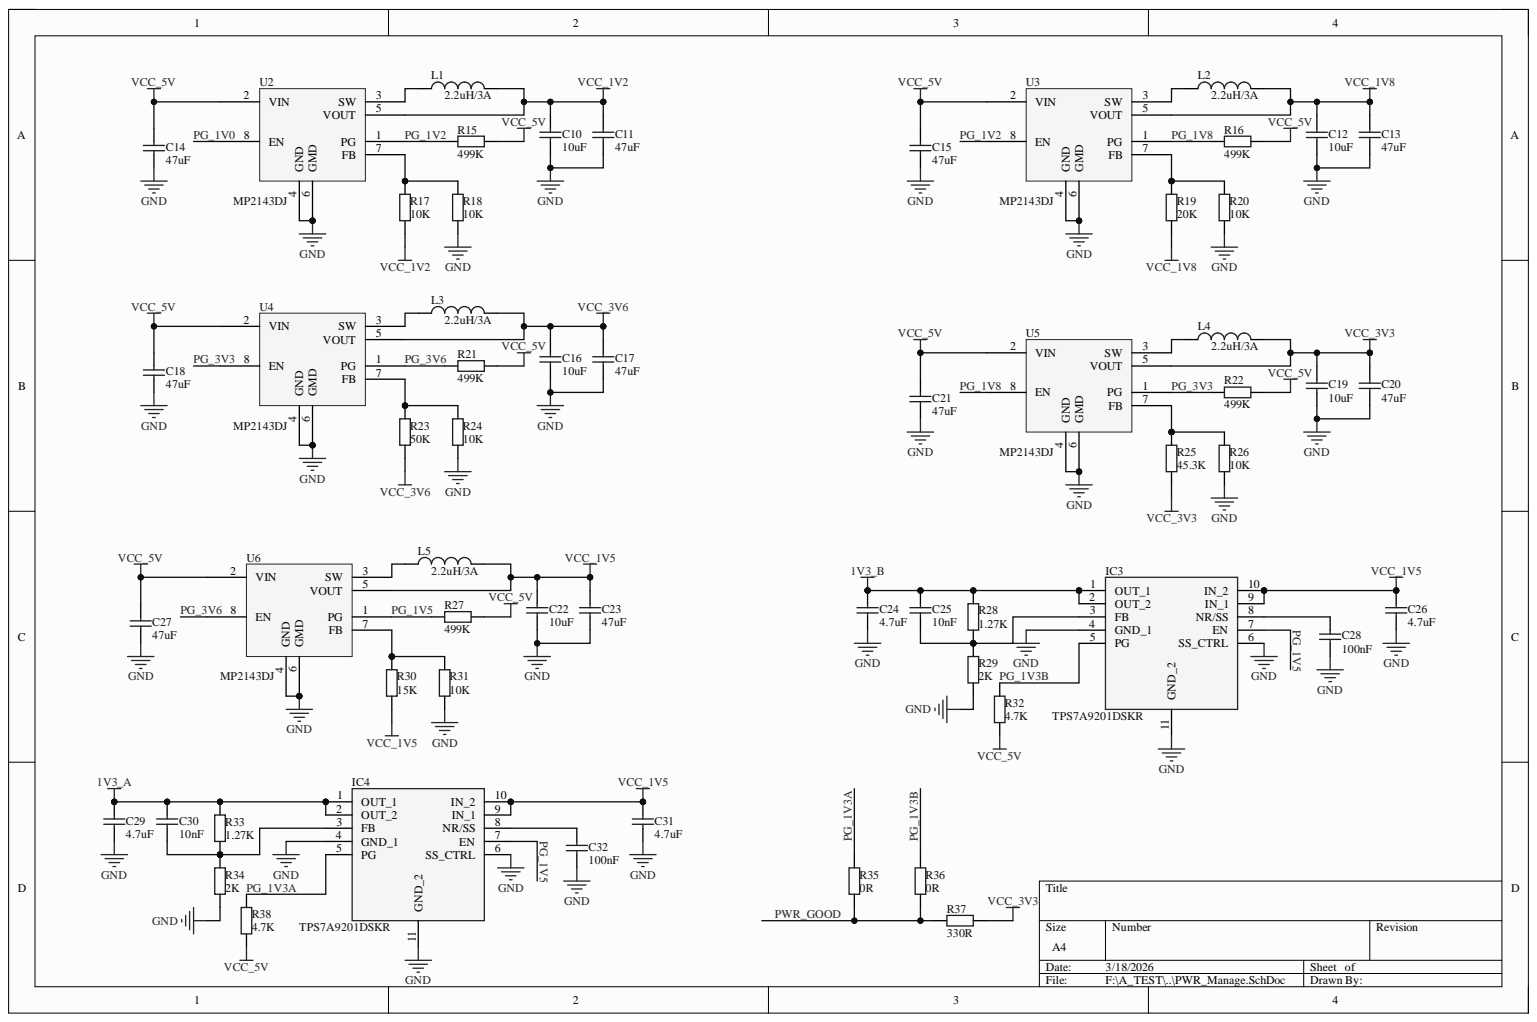
[picture p22: page 3]

OUT_2 2

GND_1 4

GND PG_1V3A

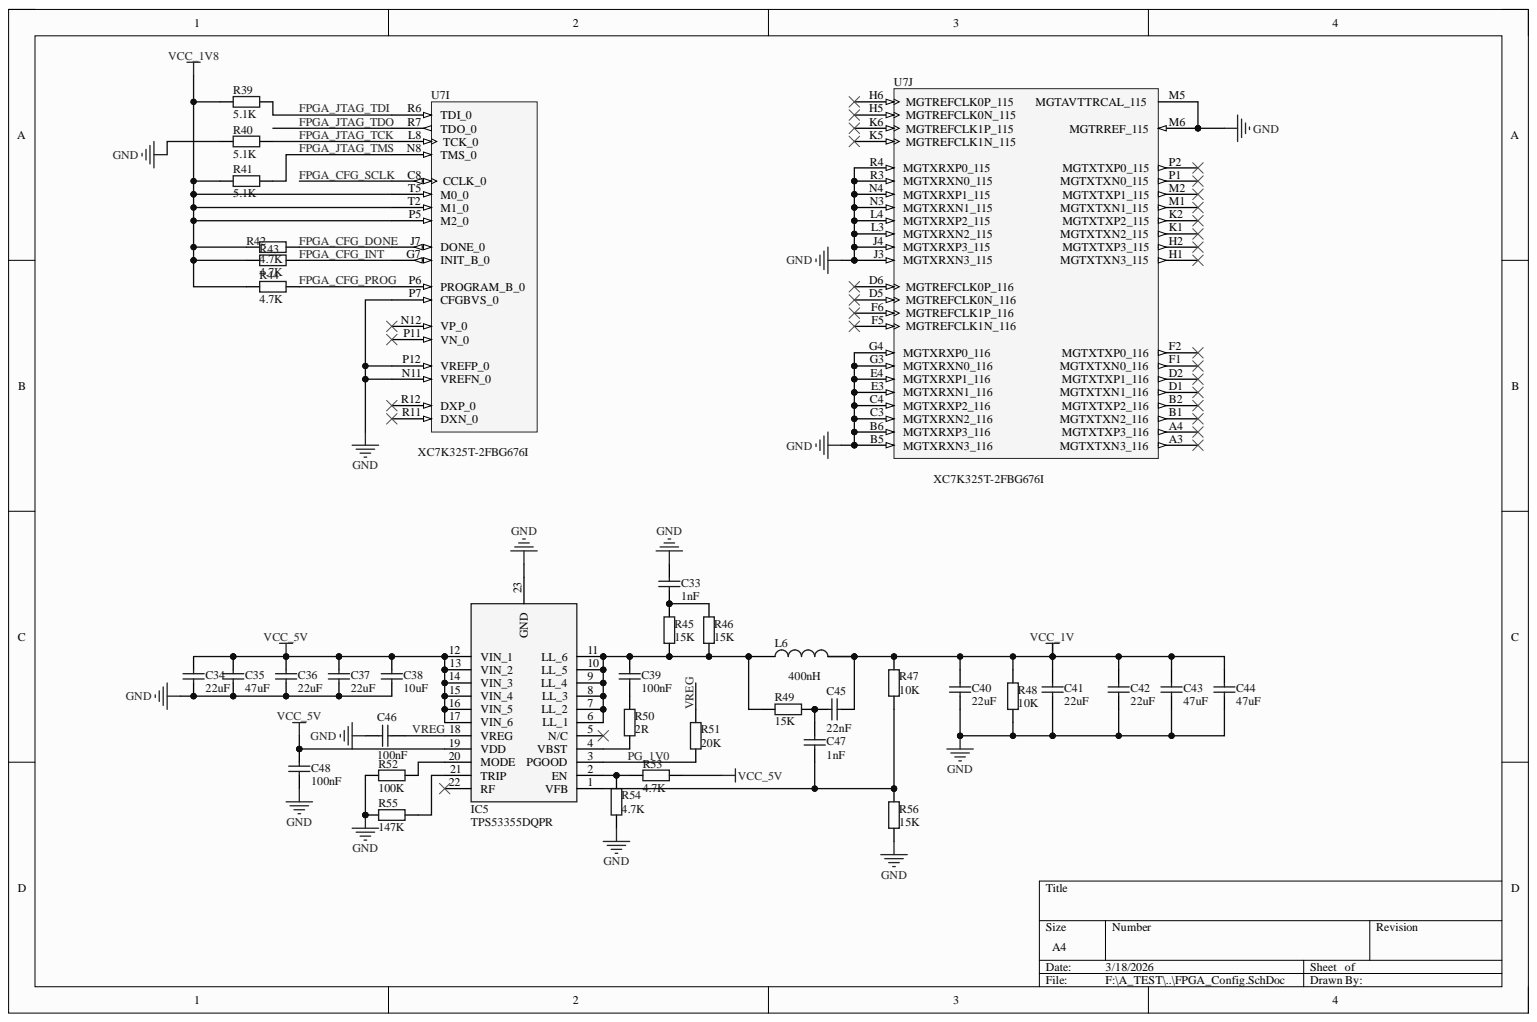
[picture p23: page 4]

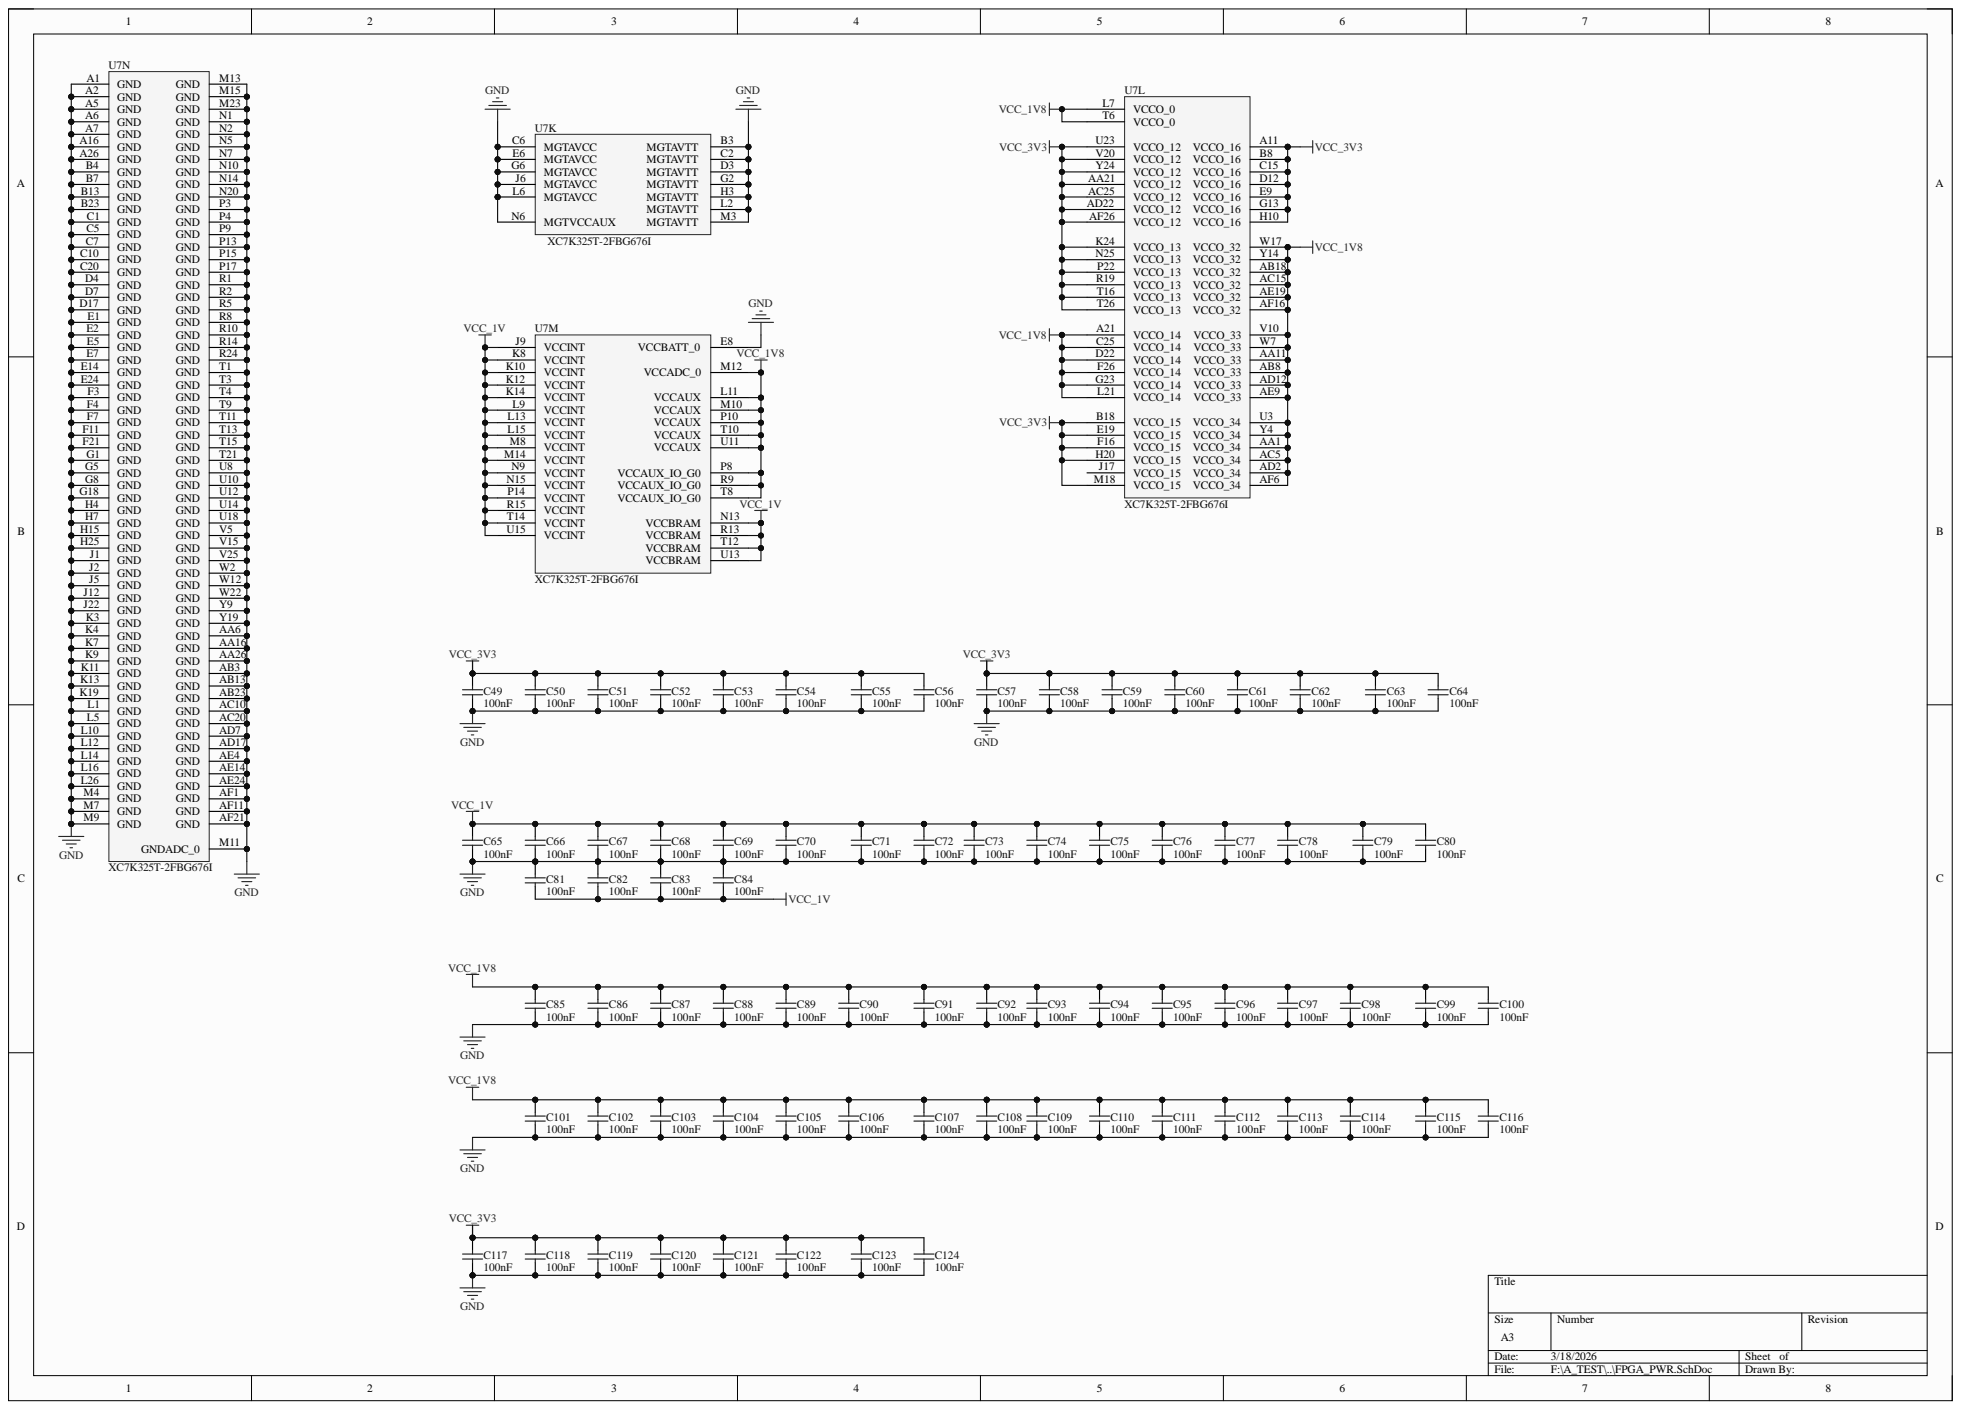
[picture p24: page 5]

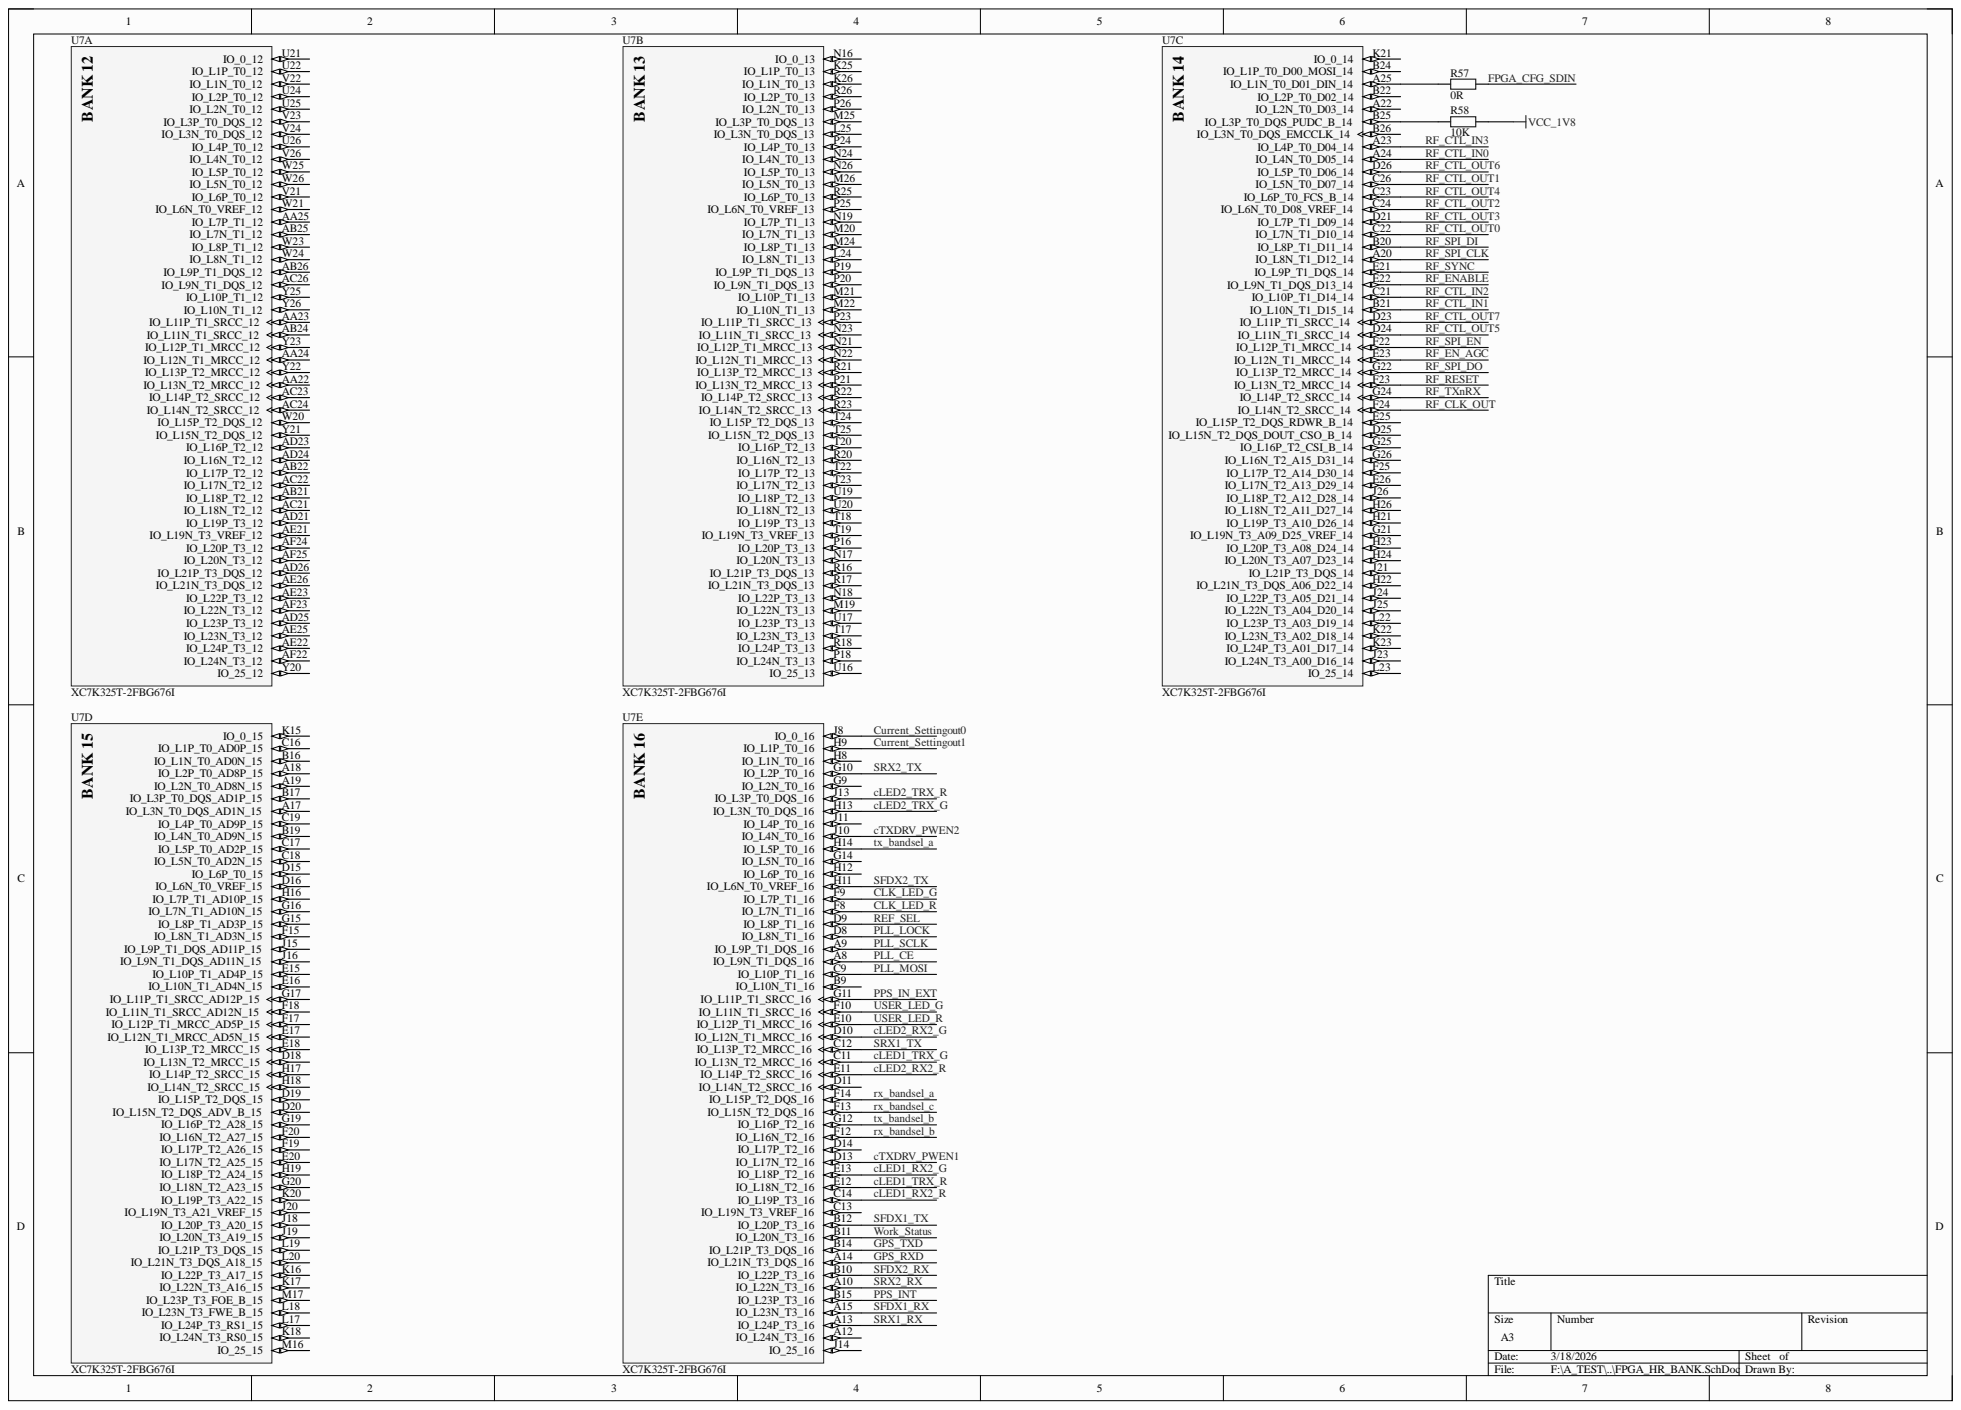
[picture p25: page 6]

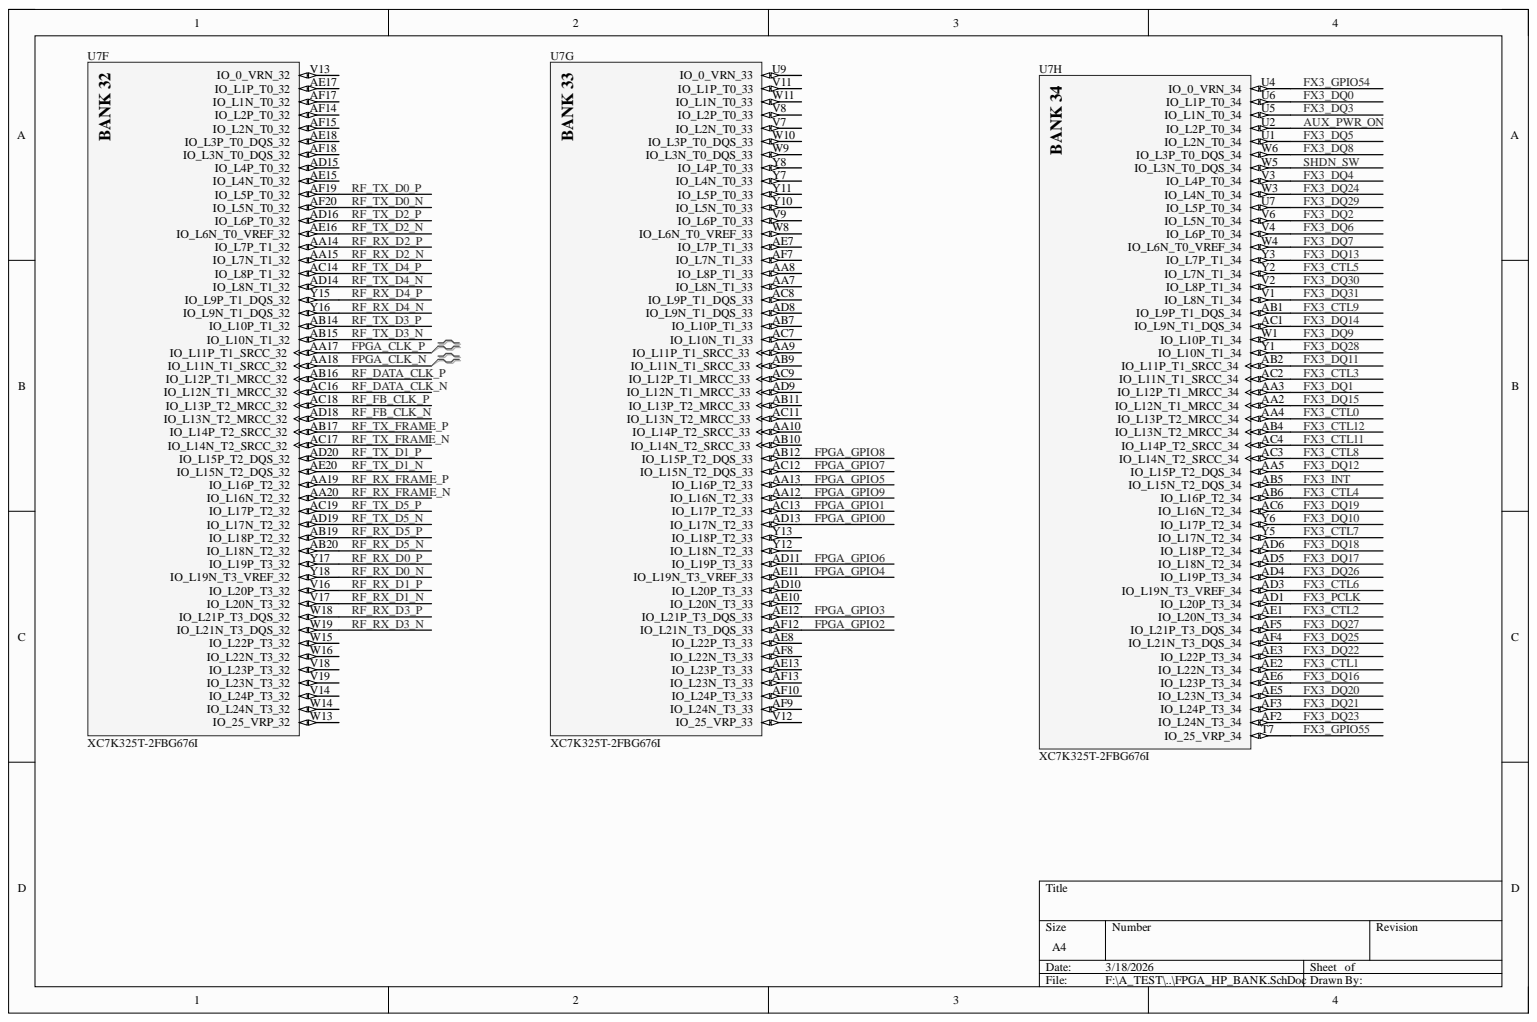
[picture p26: page 7]

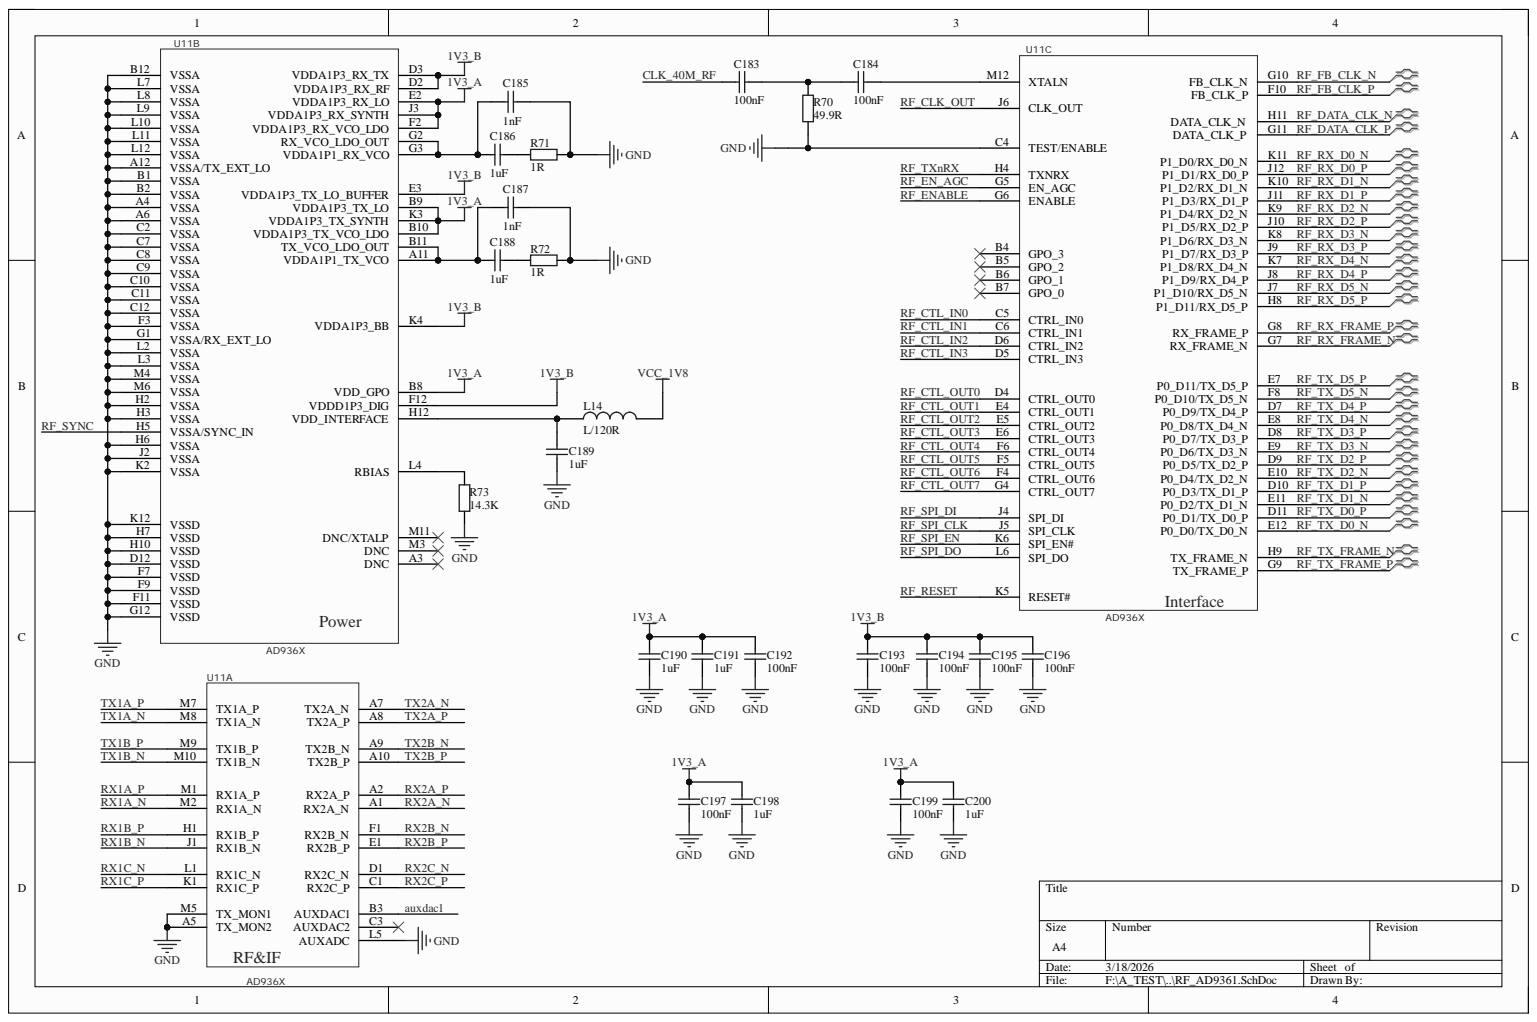
[picture p27: page 8]

L 7 | D 2 | V 3
L 8 | E 2

L 1 1 | G 2
L 1 2 | G 3
A 1 2 | 1 V 3 _B 1 | F

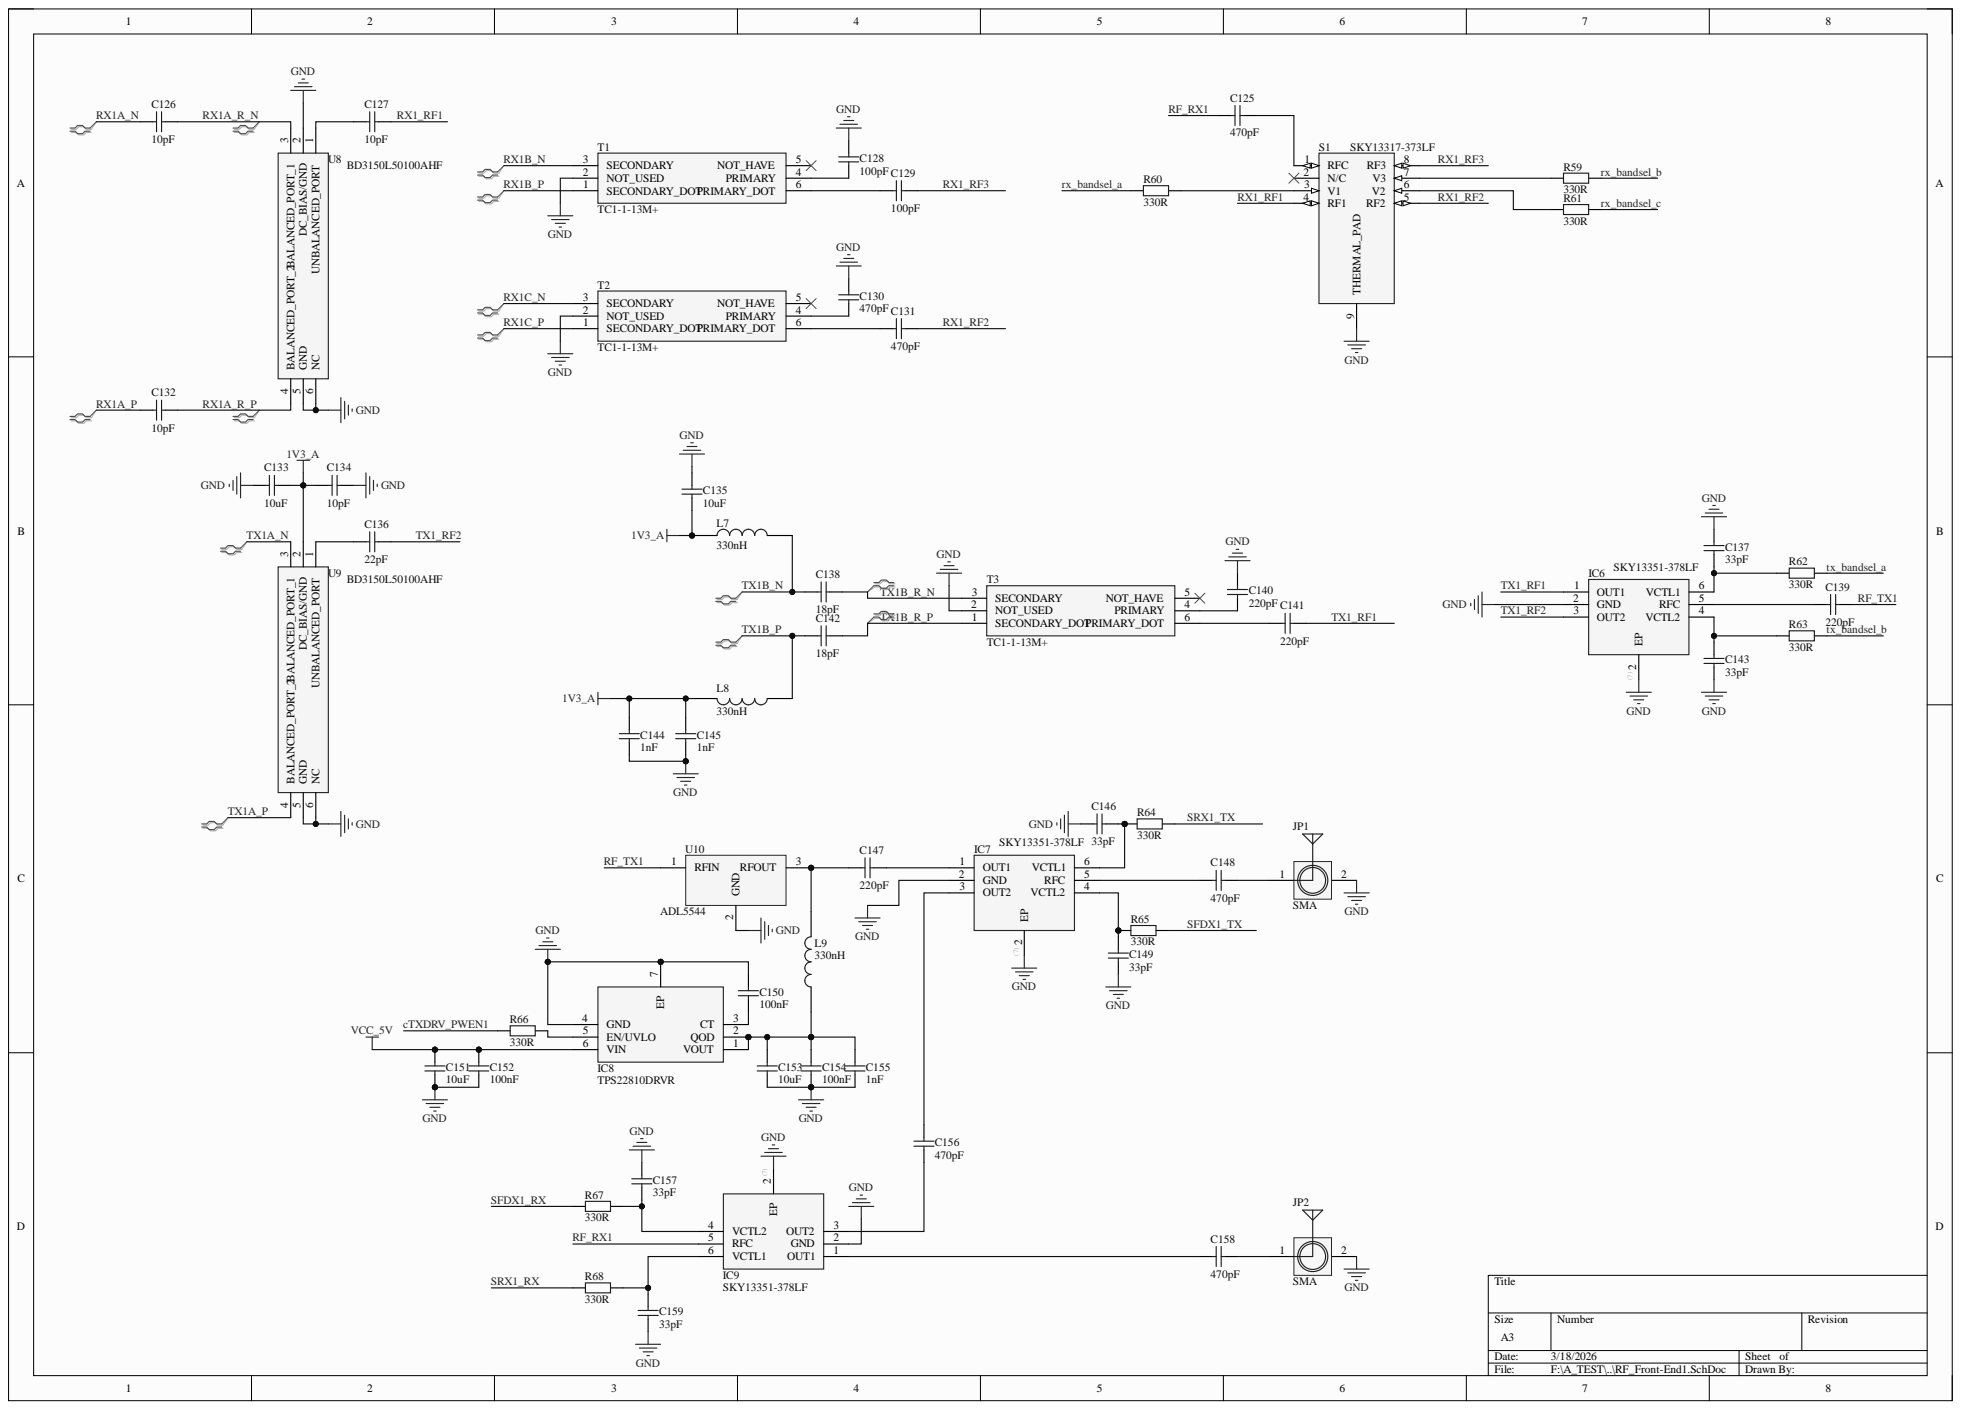
[picture p28: page 9]

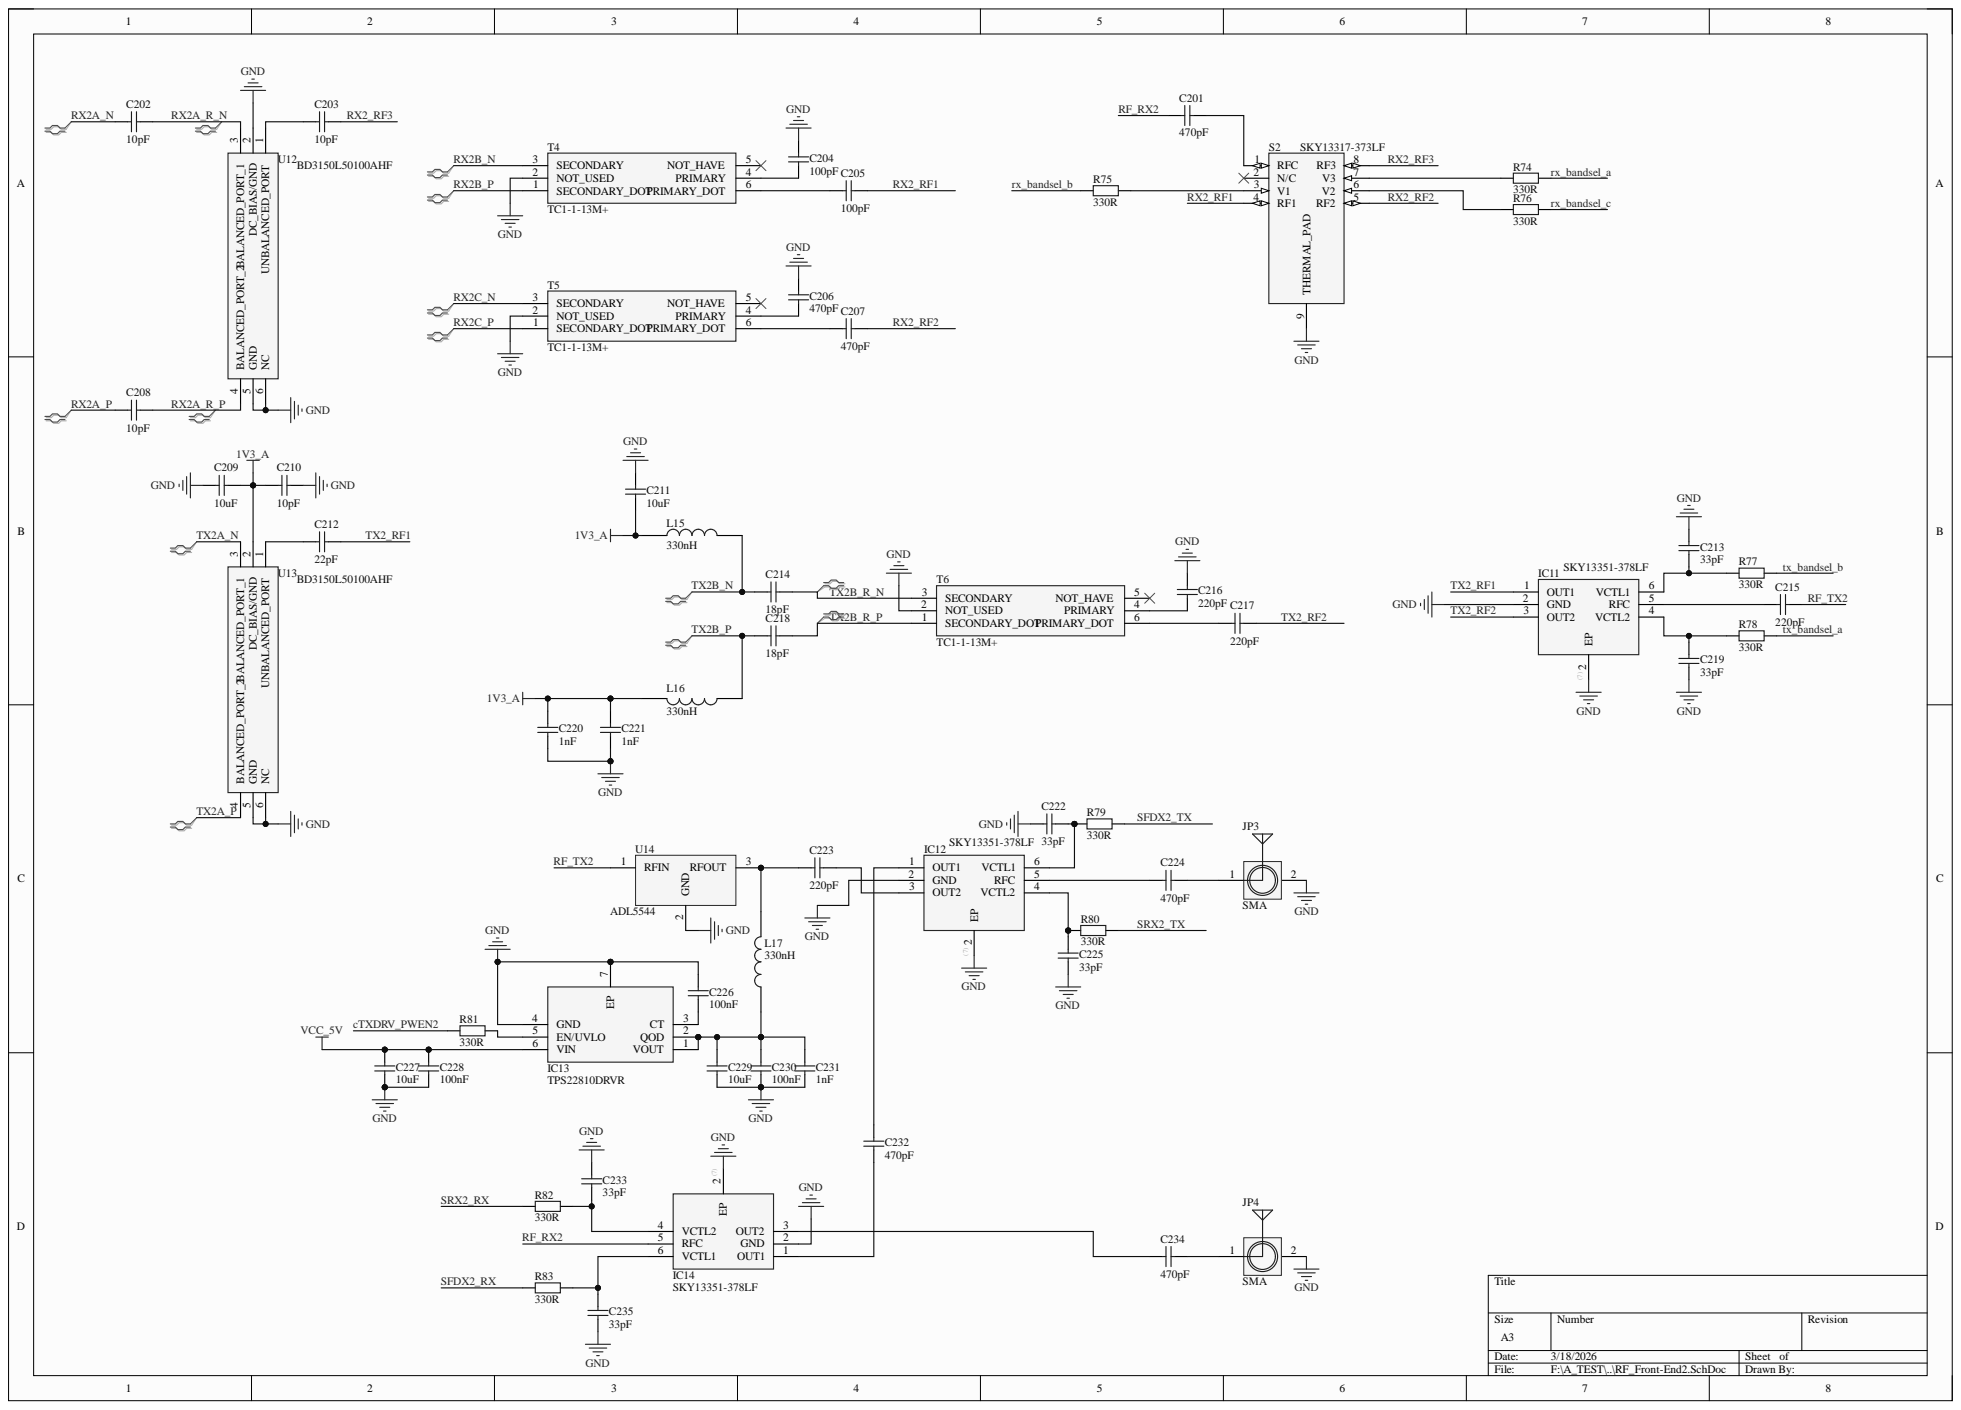
[picture p29: page 10]

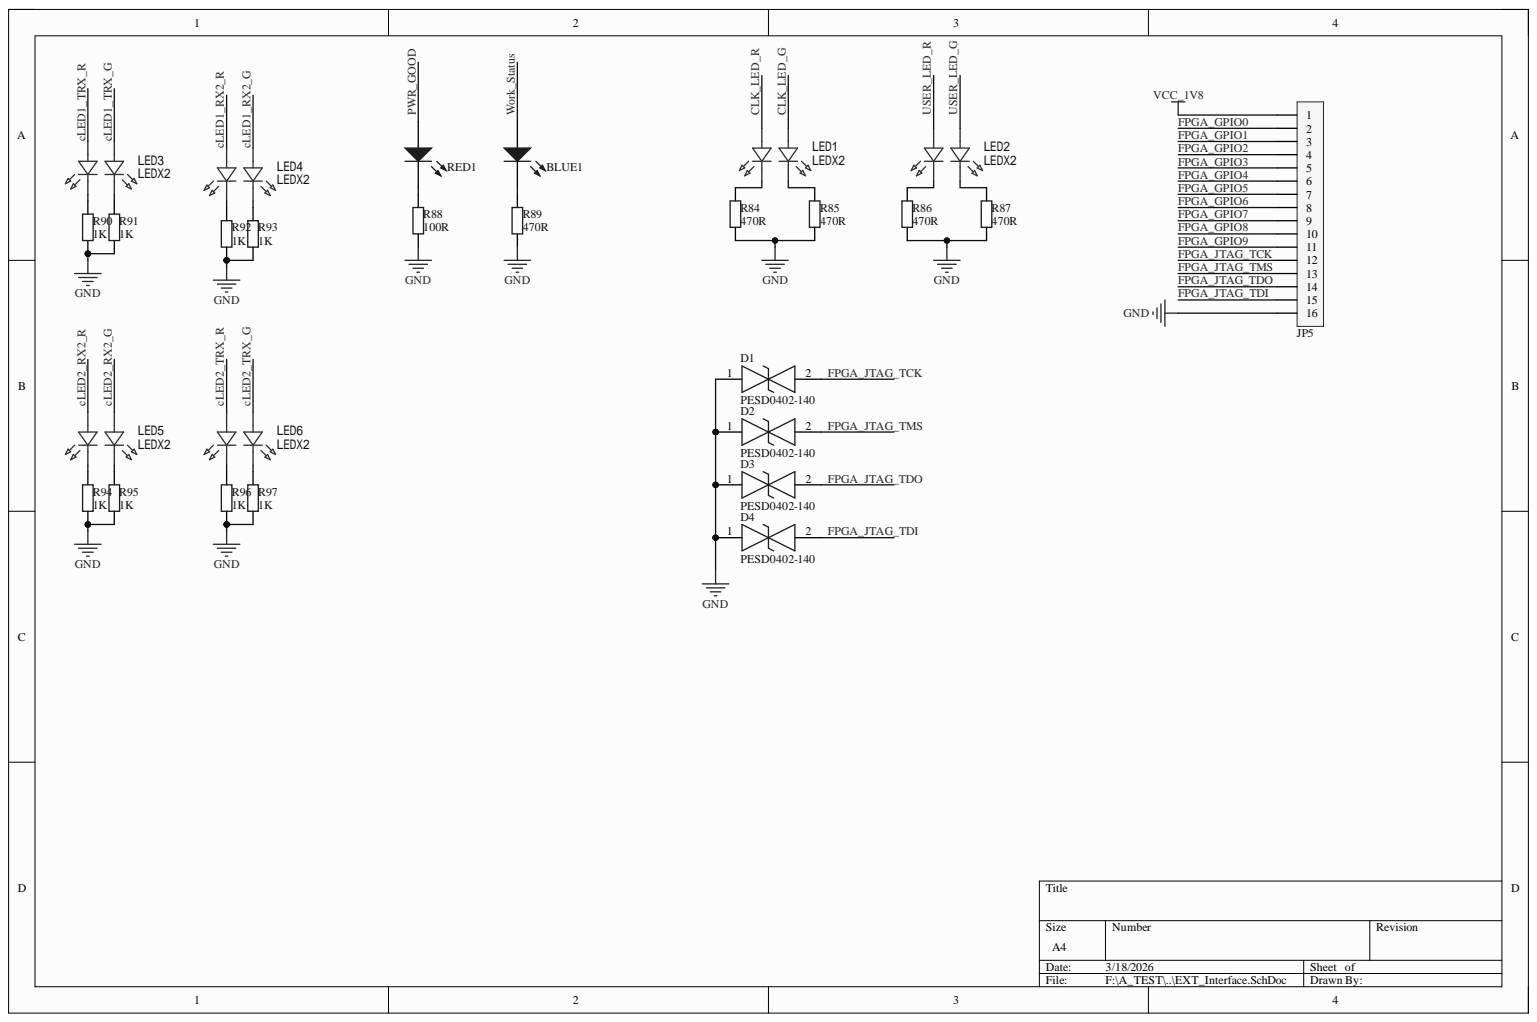
[picture p30: page 11]

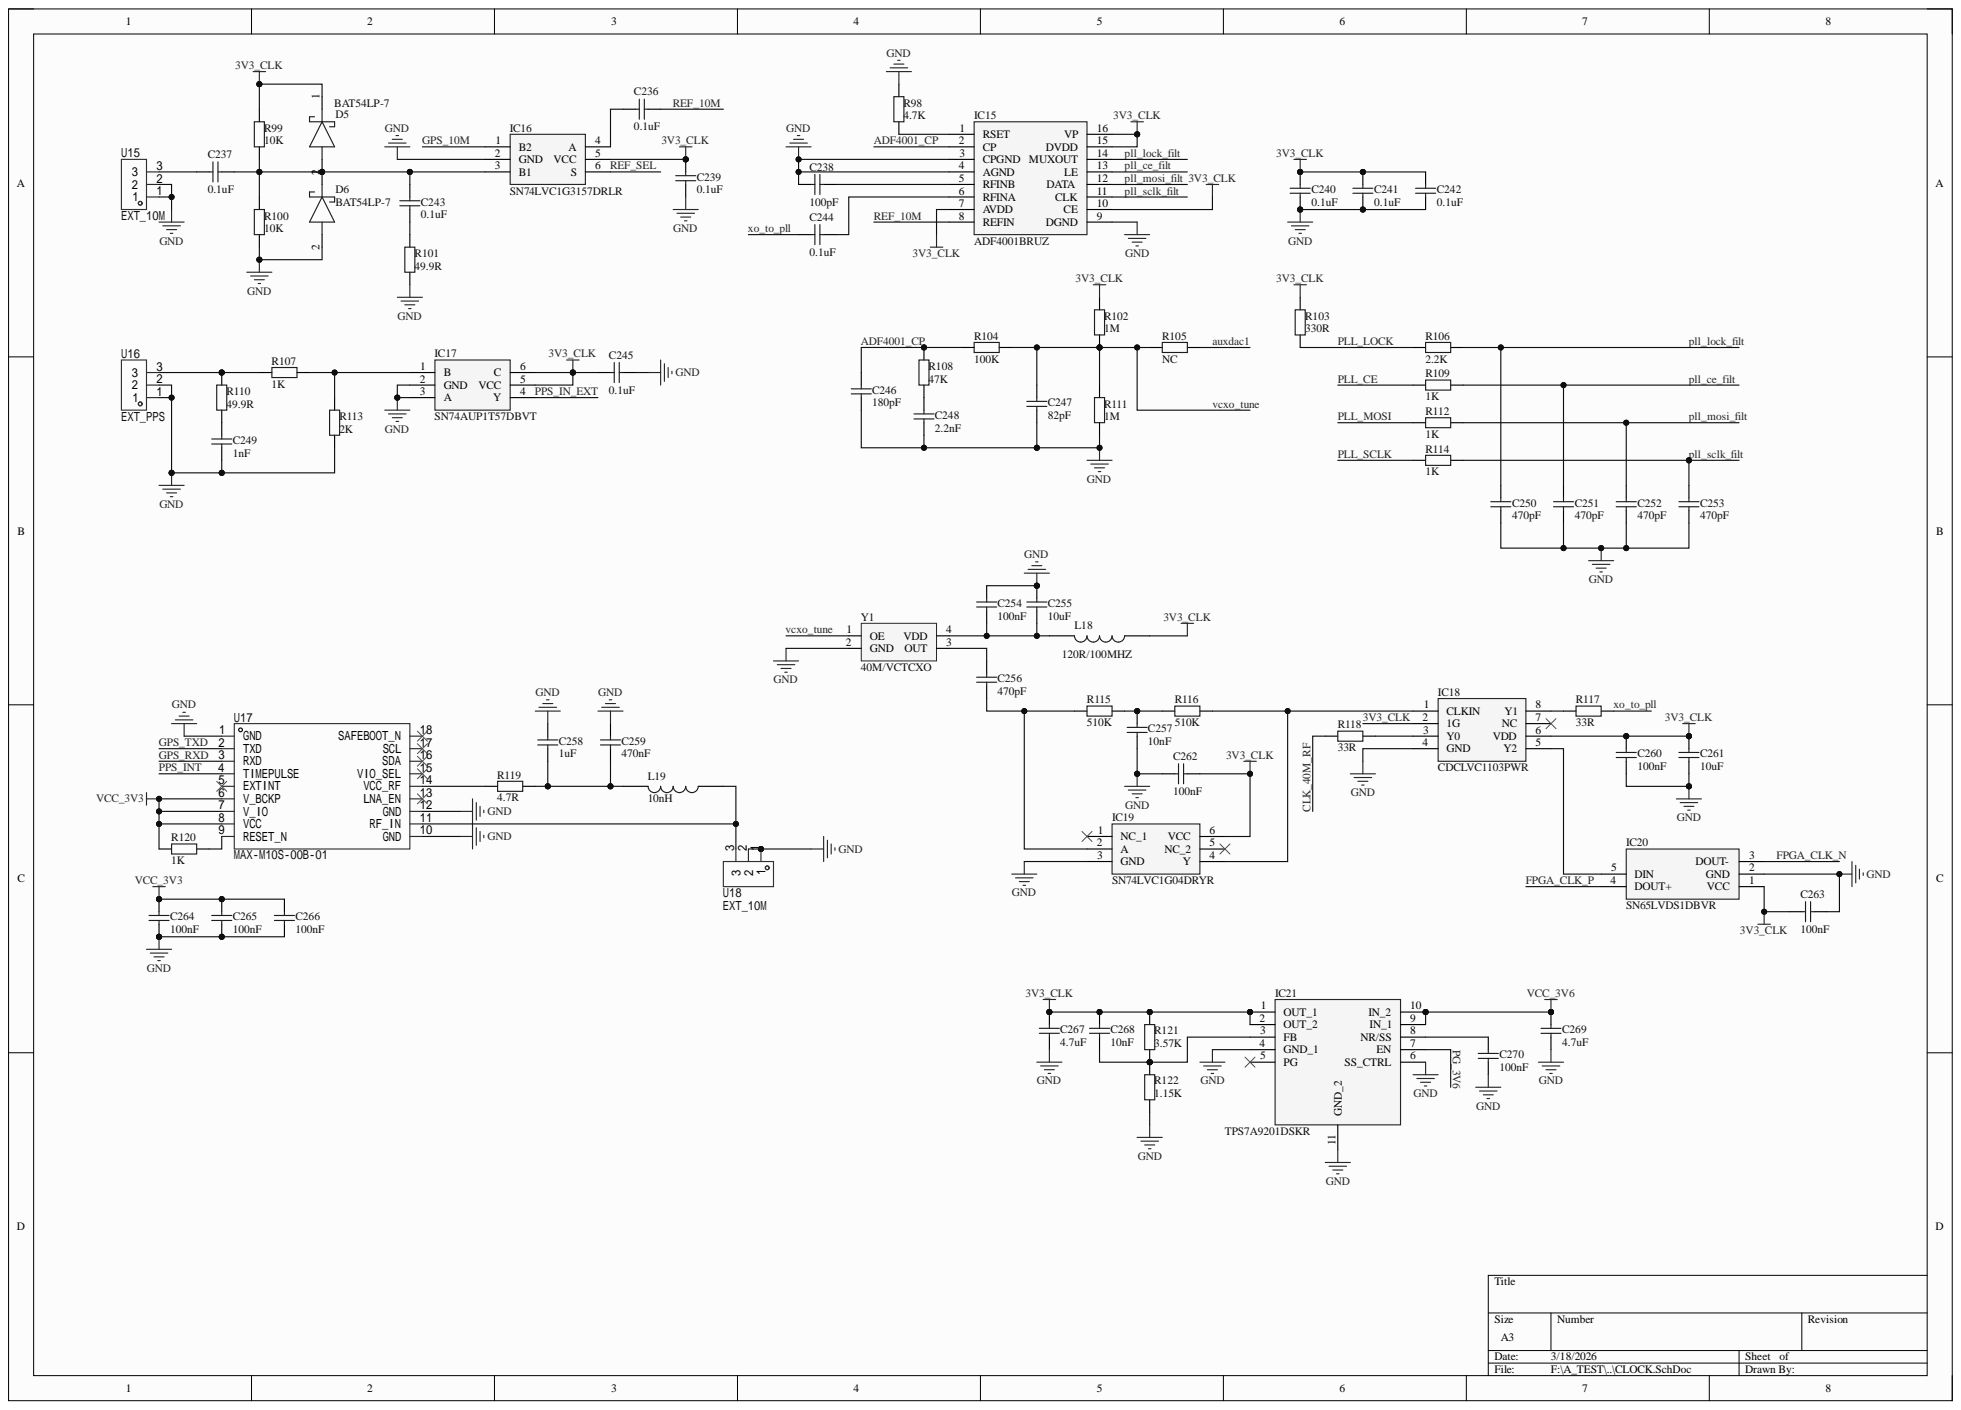
[picture p31: page 12]

RFINB 5 | pll_mosi_filt
RFINA 6 | pll_sclk_filt
AVDD 7
REFIN 8

NC vcxo_tune | 2.2K R109

GND 2
A 3
