OpenSourceSDRLab/B210-Kintex-7/(commit log)

2026-09-02 add PCB
    [PCB.DWG, PCB.step]
2026-11-13 Align repository with the OpenSourceSDRLab format
    - README, NOTICE, Apache-2.0 LICENSE for our files, English Quick Start Guide (md + PDF)
    - schematic with English cover page, local paths and hidden PDF scripts removed
    - FPGA source project (Vivado 2024.1, based on Ettus UHD v4.9.0.0) instead of a Google Drive link
    - FPGA image moved to Releases (V2.0), GNU Radio examples, white-background product photos
